pierre-raseev/tiger-timer/Code/FSD/renders/pattern_A_standard_template.png

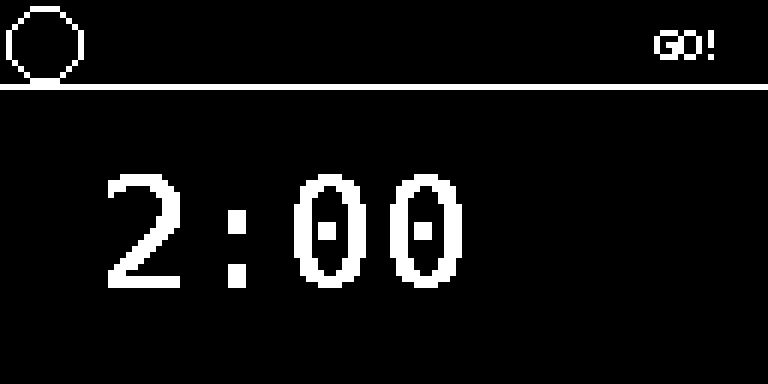
Code/FSD/renders/pattern_A_standard_template.png
