pierre-raseev/tiger-timer/Code/FSD/renders/pattern_B_menu_list.png

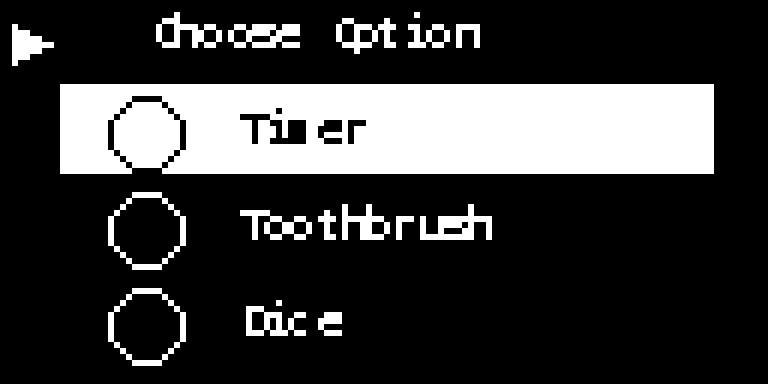
Code/FSD/renders/pattern_B_menu_list.png
