pierre-raseev/tiger-timer/Code/FSD/renders/pattern_C_leave_confirm.png

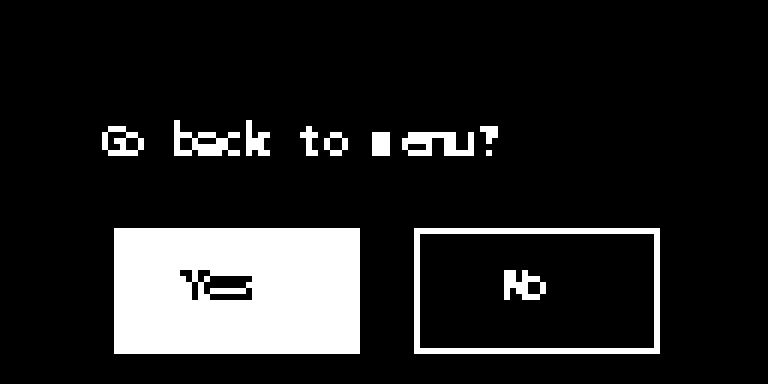
Code/FSD/renders/pattern_C_leave_confirm.png
