pierre-raseev/tiger-timer/Code/FSD/renders/pattern_D_pass_the_bomb.png

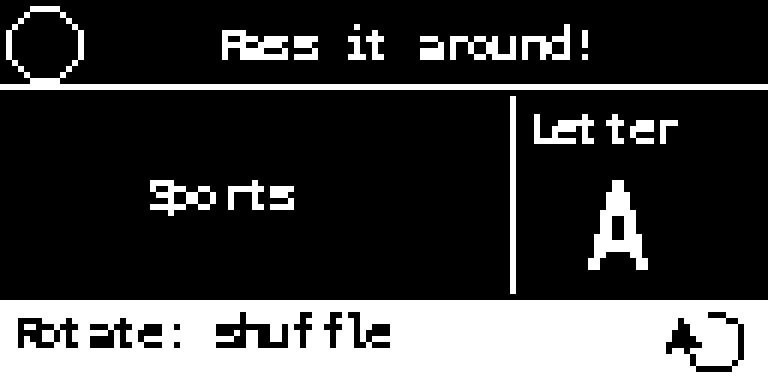
Code/FSD/renders/pattern_D_pass_the_bomb.png
