pierre-raseev/tiger-timer/Code/FSD/renders/pattern_E_remote_config.png

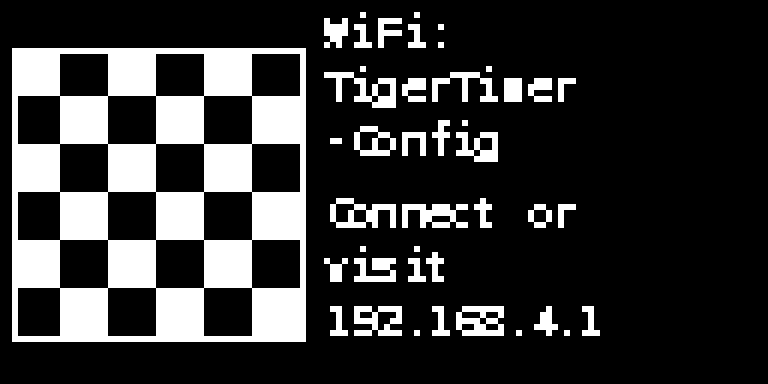
Code/FSD/renders/pattern_E_remote_config.png
