pierre-raseev/tiger-timer/Code/FSD/renders/pattern_F_tetris_ghost.png

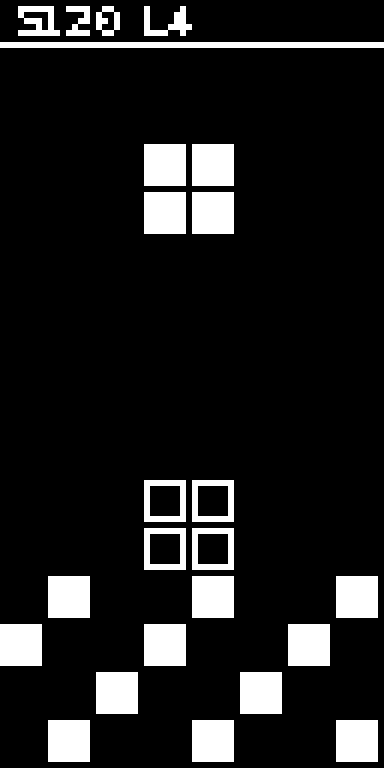
Code/FSD/renders/pattern_F_tetris_ghost.png
