pierre-raseev/tiger-timer/3D/Game Timer v1.9.1.step

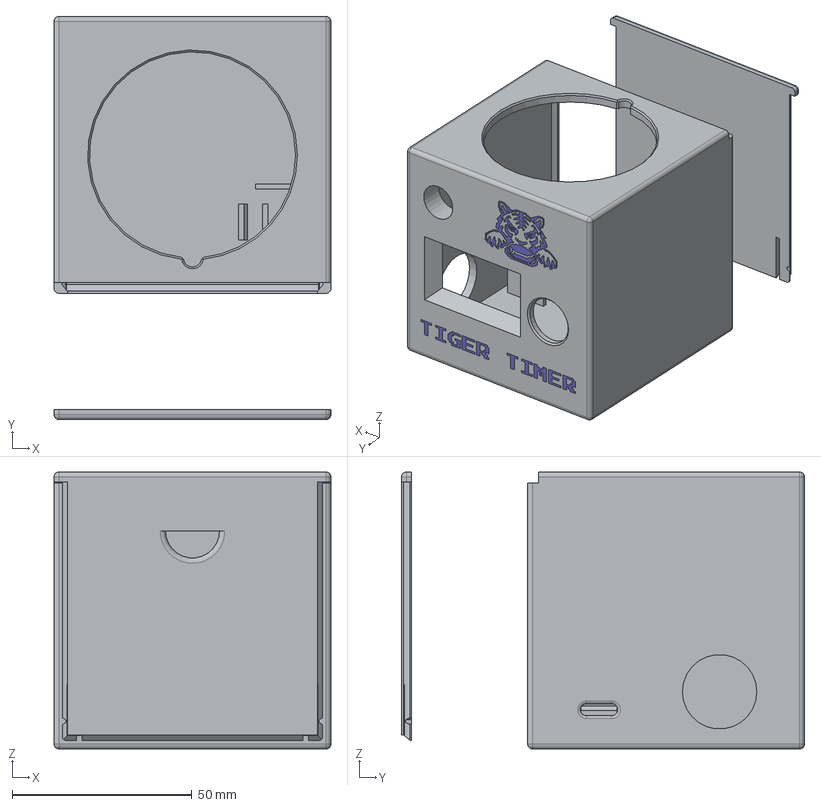
[picture p13: CAD file, 2026-11-11]
3D/Game Timer v1.9.1.step
77.0 x 112.1 x 77.0 mm
Box Body
Back Plate Body
Prints
