pierre-raseev/tiger-timer/3D/Game Timer v1.9.1-double.3mf

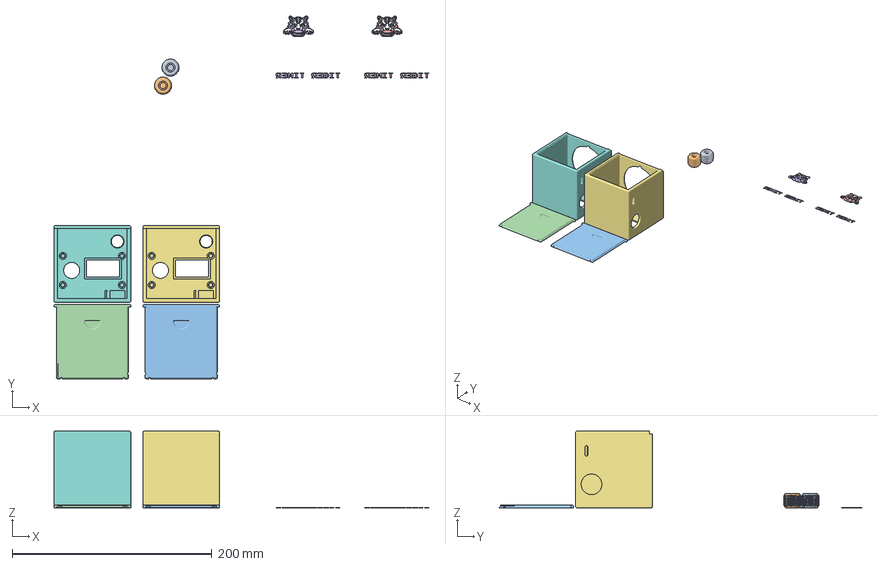
[picture p14: CAD file, 2026-11-11]
3D/Game Timer v1.9.1-double.3mf
375.7 x 363.3 x 77.0 mm
旋钮.STL x 2
Back Plate Body x 2
Prints x 2
Box Body x 2
