pierre-raseev/tiger-timer/(list of files, cad)

Other CAD files:
3D/Game Timer v1.9.1.FCStd
