pierre-raseev/tiger-timer/Code/tiger_timer/tiger_timer.ino

/*
  ============================================================================
  TIGER TIMER  --  firmware for a battery-powered, pocket party-game console
  ============================================================================
  Hardware: Seeed XIAO ESP32C6. Full hardware spec, wiring, and every
  feature's exact intended behavior are documented in the companion
  functional specification document, TigerTimer_FSD.md - if this header and
  that document ever disagree, the FSD is the source of truth; please update
  one or the other rather than letting them drift.

  This comment is intentionally a *summary*, not a duplicate of the FSD - see
  TigerTimer_FSD.md for exact numbers, timings, and per-game rules; see
  TigerTimer_DevPlan.md for how this was originally broken into build phases.

  --- Quick wiring reference (see FSD Sec.2 for the authoritative version) ---
    Arcade button switch   -> D1 + GND   (INPUT_PULLUP, LOW = pressed)
    Arcade button LED (5V) -> D2 + GND   (direct GPIO drive, no boost needed)
    Buzzer (passive piezo) -> D3 + GND   (PWM-driven via LEDC, see playNote())
    OLED + EC11 encoder: one combined module (1.3" SH1106 128x64, I2C addr 0x3C),
      header, seen from the back left to right: 3V3-5V GND BAK TRB TRA PUSH SCL SDA CONFIRM
      SDA->D4  SCL->D5  TRA(CLK)->D10  TRB(DT)->D8  PUSH(SW)->D9  VCC->3V3  GND->GND
      (BAK/CON buttons not connected)
    Power: 3.7V LiPo on the XIAO's BAT pads, through a physical power switch.
    Charged by the XIAO's on-board charger via its USB-C (only while switched on).

  Libraries needed (Arduino Library Manager):
    - "Adafruit SH110X" (pulls in Adafruit GFX Library + Adafruit BusIO)
    - "ArduinoJson" v7.x specifically (used only by web_config.ino)
  Plus two files vendored directly into this sketch (not Library-Manager
  installs - see the comment at the top of each for why):
    - tigertimer_qrcode.h/.c  - a renamed copy of the "QRCode" library, to avoid
      a real collision with a same-named header the ESP32 core bundles
    - press_start_2p_font.h - a custom Adafruit_GFX bitmap font, converted
      from a user-provided TTF, used for the splash/title-bar text

  --- The one input model, used everywhere (FSD Sec.3.2 has the full table) ---
  There are exactly two physical controls and their meaning is consistent
  across every screen except where a specific game overrides it:
    - Arcade button, short press  = confirm / that screen's primary action.
    - Encoder, short click        = same as above in menu-type screens; a
                                     few games (Timer, Chess) repurpose it as
                                     pause/resume instead, since there's
                                     nothing to "confirm" mid-round.
    - Encoder, held + turned      = adjust buzzer volume, from anywhere, any
                                     time - shows a full-screen live indicator
                                     while held, restores the prior screen on
                                     release.
    - Encoder, held 1s (no turn)  = open "Go back to menu?" if inside a game;
                                     does nothing if already in the menu
                                     hierarchy. This is the ONLY way to leave
                                     a game - there is deliberately no
                                     un-confirmed direct exit, so a mid-round
                                     game can never be lost by accident.
  A hold that gets "claimed" by rotation (volume) never also fires a click or
  the long-press menu gesture afterward - see readEncoderButton()/readEncoder()
  and the comment on swClaimedByVolume/swLongFired for exactly how that's
  arbitrated.

  --- What's in this file vs. the other tabs ---
    tiger_timer.ino     - everything except the web config tool: drivers,
                           menu/settings, every game, localization, splash
                           screens, the volume system.
    web_config.ino       - "Config Mode": turns the device into its own WiFi
                           AP serving a small web app (web/config.html) for
                           editing things a single knob can't reasonably
                           edit - menu order/enable, trivia question content,
                           Pass-the-Bomb category list, startup behavior.
                           Entered only from Settings, off otherwise, so it
                           costs zero battery during normal play.
    tigertimer_qrcode (.h/.c), press_start_2p_font.h - vendored assets, see above.
    data/*.csv           - trivia question content (15-column format, see
                           the comment above loadTriviaQuestion() and FSD
                           Sec.5.8).
    config_html.h         - the Config Mode web page, gzipped into the firmware. GENERATED from
                            web/config.html by tools/embed_config_html.py - edit the .html,
                            re-run the script. Lives in firmware (not LittleFS) so a firmware
                            update also updates the page and never touches the trivia files.

  --- Notable design decisions worth knowing before changing things ---
    - MENU_ORDER is a runtime array (not compile-time const) specifically so
      Config Mode can rewrite and persist it; see rebuildVisibleMenu() for
      how disabled games get filtered out of it without losing their saved
      position.
    - Games list their labels by looking up the game's *id*, not by array
      position (see menuLabelForGame()) - this was a real bug fixed early
      on: a positional label array silently mismatches once the menu order
      becomes user-configurable.
    - Word-wrapping is always done by this code's own logic with the display
      library's built-in auto-wrap explicitly disabled first - measuring
      text width with auto-wrap still enabled returns a size that already
      reflects the (possibly mid-word-broken) wrapped layout, not the true
      single-line width, which silently breaks wrap decisions. See
      drawRotatedWrappedText()/drawWrappedText() for the fix.
    - Tetris and Star Drop temporarily call display.setRotation(1) to use
      the panel's long axis as their vertical "falling" axis, and always
      restore rotation(0) before returning - every draw function that does
      this says so explicitly in its own comment; if you add a new rotated
      screen, follow the same bracket-tightly-and-always-restore pattern.
    - Config Mode's WiFi network is deliberately open (no password) so
      phones can captive-portal straight in without typing anything.
    - The trivia CSV format has no quote/escape support (plain comma-split)
      - question/answer text must not contain literal commas or newlines;
      the web editor strips them defensively on save.
  ============================================================================
*/


#include <Wire.h>
#include <Adafruit_GFX.h>
#include "press_start_2p_font.h" // generated from the user-provided PressStart2P-Regular.ttf - same font as the boot splash's TIGER/TIMER wordmark
#include <Adafruit_SH110X.h>
#include <Preferences.h>
#include <LittleFS.h>
#include "esp_sleep.h"
#include "driver/rtc_io.h" // LP-IO pull-up for the deep-sleep wake pin
#include "driver/gpio.h"   // gpio_get_level() - IRAM-safe pin read for the encoder interrupt
#include <WiFi.h>
#include <WebServer.h>
#include <DNSServer.h> // used by web_config.ino for the captive-portal redirect
#include <Update.h>    // firmware update uploaded from the Remote Config page (web_config.ino)
#include "config_html.h" // the Remote Config page, gzipped - GENERATED from web/config.html by tools/embed_config_html.py
#include <ArduinoJson.h>
#include "tigertimer_qrcode.h" // vendored QR encoder (see tigertimer_qrcode.h/.c) - avoids a name collision
                             // with the ESP32 core's own bundled qrcode.h (used for WiFi provisioning)
#include "cp437_utf8.h" // CP437 <-> UTF-8 conversion for the Remote Config web page (web_config.ino)
#include <math.h> // roundf(), used when drawing the WiFi QR code at an arbitrary pixel size // Library Manager: "ArduinoJson" by Benoit Blanchon - used only by the
                          // Config Mode web server (web_config.ino) to parse/build the config page's requests

// ---- Firmware version ----
// Shown on the Remote Config page. Bump it for every change, and publish a GitHub release
// "vX.Y.Z" with the built app .bin attached, so a box can be updated from Remote Config.
const char* FW_VERSION = "1.0.6";
// A firmware upload is only installed if this exact text appears somewhere in the uploaded file,
// i.e. the file really is a Tiger Timer build (any build contains it, since the update code
// below searches for it). Never change it, or older boxes would refuse the new firmware.
const char TT_FW_MARKER[] = "TigerTimer-firmware-id-7d1e9a";

// ---- Pins ----
const int BUTTON_PIN   = D1;
const int BUTTON_LED   = D2;
const int BUZZER_PIN    = D3;
const int ENCODER_CLK  = D10;
const int ENCODER_DT   = D8;
const int ENCODER_SW   = D9;

// ---- OLED ----
#define SCREEN_WIDTH 128
#define SCREEN_HEIGHT 64
#define OLED_I2C_ADDR 0x3C
Adafruit_SH1106G display = Adafruit_SH1106G(SCREEN_WIDTH, SCREEN_HEIGHT, &Wire, -1);

// ---- Splash screen: tiger logo bitmaps (80x53), closed-mouth and open-mouth "roar" frames ----
const int SPLASH_TIGER_WIDTH = 80;
const int SPLASH_TIGER_HEIGHT = 53;
// 80x53 pixels, 530 bytes each
const unsigned char PROGMEM TIGER_BITMAP[] = {
  0x00, 0x00, 0xFC, 0x00, 0x00, 0x00, 0x00, 0x1F, 0x00, 0x00, 0x00, 0x01,
  0x8E, 0x00, 0x00, 0x00, 0x00, 0x71, 0x80, 0x00, 0x00, 0x01, 0x03, 0x80,
  0x3F, 0xFC, 0x01, 0xE0, 0x80, 0x00, 0x00, 0x01, 0x01, 0xE0, 0x3F, 0xFC,
  0x07, 0xC0, 0xC0, 0x00, 0x00, 0x01, 0x39, 0xF1, 0xC3, 0xC3, 0x8F, 0x9C,
  0xC0, 0x00, 0x00, 0x01, 0x3C, 0xFF, 0x03, 0xC0, 0x7F, 0x1C, 0x80, 0x00,
  0x00, 0x01, 0x3C, 0x3C, 0x7F, 0xFE, 0x1E, 0x3C, 0xC0, 0x00, 0x00, 0x01,
  0x9F, 0x31, 0xFF, 0xFF, 0x8C, 0x7D, 0x80, 0x00, 0x00, 0x00, 0x9F, 0xE2,
  0x03, 0xC0, 0x47, 0xF9, 0x00, 0x00, 0x00, 0x00, 0xCF, 0x80, 0x0F, 0xF0,
  0x00, 0xF3, 0x00, 0x00, 0x00, 0x00, 0x6E, 0x00, 0x1F, 0xFC, 0x00, 0x76,
  0x00, 0x00, 0x00, 0x00, 0x3C, 0x30, 0x79, 0xCE, 0x04, 0x3C, 0x00, 0x00,
  0x00, 0x00, 0x38, 0x78, 0xC3, 0xC3, 0x1E, 0x1C, 0x00, 0x00, 0x00, 0x00,
  0x70, 0xC0, 0x07, 0xE0, 0x01, 0x0E, 0x00, 0x00, 0x00, 0x00, 0x61, 0x80,
  0x1F, 0xF8, 0x01, 0x86, 0x00, 0x00, 0x00, 0x00, 0xC3, 0xC0, 0x39, 0xDC,
  0x03, 0xC3, 0x00, 0x00, 0x00, 0x01, 0xD3, 0xC0, 0x21, 0xC4, 0x03, 0xCB,
  0x80, 0x00, 0x00, 0x03, 0xE7, 0xF0, 0x03, 0xC0, 0x07, 0xE7, 0xC0, 0x00,
  0x00, 0x07, 0xE4, 0x78, 0x07, 0xE0, 0x1F, 0x27, 0xE0, 0x00, 0x00, 0x07,
  0xC0, 0x7E, 0x04, 0x30, 0x3F, 0x03, 0xE0, 0x00, 0x00, 0x01, 0xC0, 0x6F,
  0x00, 0x00, 0xF7, 0x03, 0x80, 0x00, 0x00, 0x03, 0x80, 0x6D, 0xC0, 0x03,
  0xB6, 0x01, 0xC0, 0x00, 0x00, 0x03, 0x83, 0x37, 0x70, 0x0E, 0xEE, 0x40,
  0xC0, 0x00, 0x00, 0x07, 0x02, 0x38, 0xF0, 0x0F, 0x1C, 0x40, 0xE0, 0x00,
  0x00, 0x07, 0x33, 0x0F, 0xF0, 0x0F, 0xF0, 0xC4, 0xE0, 0x00, 0x00, 0x0F,
  0x73, 0x87, 0x30, 0x04, 0xE1, 0xC6, 0xF0, 0x00, 0x00, 0x0F, 0xE3, 0x80,
  0x60, 0x06, 0x01, 0xC3, 0xF8, 0x00, 0x00, 0x0B, 0xE3, 0xE0, 0x40, 0x02,
  0x07, 0xC3, 0xD8, 0x00, 0x00, 0x03, 0xE1, 0xFE, 0x00, 0x00, 0x3F, 0x83,
  0xC0, 0x00, 0x00, 0x03, 0xE0, 0xFC, 0x00, 0x00, 0x3F, 0x03, 0xE0, 0x00,
  0x00, 0x0F, 0xF8, 0x38, 0x00, 0x00, 0x1E, 0x1F, 0xF0, 0x00, 0x00, 0x7C,
  0x7E, 0x38, 0x38, 0x1C, 0x0C, 0x3E, 0x3F, 0x00, 0x01, 0x80, 0x3E, 0x70,
  0x1F, 0xF8, 0x0F, 0x7C, 0x01, 0xC0, 0x03, 0x00, 0x0F, 0xF8, 0x0F, 0xF0,
  0x0F, 0xF0, 0x00, 0x60, 0x0C, 0x00, 0x07, 0xFC, 0x07, 0xE0, 0x1F, 0xE0,
  0x00, 0x30, 0x18, 0x00, 0x03, 0xFE, 0x00, 0x00, 0x7F, 0xC0, 0x00, 0x18,
  0x30, 0x00, 0x01, 0xFE, 0x00, 0x00, 0x7F, 0x80, 0x00, 0x0C, 0x60, 0x00,
  0x00, 0xF0, 0x7F, 0xFE, 0x0F, 0x80, 0x00, 0x06, 0xC0, 0x63, 0x08, 0xE3,
  0xFF, 0xFF, 0xC7, 0x98, 0xC6, 0x03, 0xCC, 0x61, 0x8C, 0xCF, 0xFF, 0xFF,
  0xF3, 0xB1, 0xC6, 0x31, 0xCC, 0x61, 0xCF, 0x8F, 0xFF, 0xFF, 0xF1, 0xB3,
  0xC7, 0x3B, 0xDC, 0x73, 0xCF, 0x0F, 0xFF, 0xFF, 0xF0, 0xF3, 0xCE, 0x39,
  0xDC, 0xF1, 0xDE, 0x63, 0xFF, 0xFF, 0xC6, 0x7B, 0xCF, 0x39, 0xDD, 0xE3,
  0xD8, 0xF0, 0xFF, 0xFF, 0x0F, 0x19, 0xC7, 0xBB, 0x7D, 0xE3, 0xF1, 0xB0,
  0x00, 0x00, 0x1F, 0x8F, 0xC7, 0xBE, 0x1D, 0xB2, 0x63, 0xB0, 0x00, 0x00,
  0xFD, 0xC6, 0x4D, 0xBC, 0x07, 0x9E, 0x03, 0xB0, 0xC0, 0x03, 0xFD, 0xC0,
  0x79, 0xE0, 0x03, 0x8E, 0x03, 0x9C, 0xFF, 0xFF, 0xF9, 0xC0, 0x71, 0xC0,
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
};

// ---- Splash screen: "TIGER"/"TIMER" wordmark bitmaps (40x8 each), rendered in the Press Start 2P
// pixel font, used for the slide-in animation ----
const int SPLASH_WORD_WIDTH = 40;
const int SPLASH_WORD_HEIGHT = 8;
// 40x8 pixels each, 40 bytes each
const unsigned char PROGMEM WORD_TIGER_BITMAP[] = {
  0x7E, 0x7E, 0x3E, 0xFE, 0xFC, 0x18, 0x18, 0x60, 0xC0, 0xC6, 0x18, 0x18,
  0xC0, 0xC0, 0xC6, 0x18, 0x18, 0xCE, 0xFC, 0xCE, 0x18, 0x18, 0xC6, 0xC0,
  0xF8, 0x18, 0x18, 0x66, 0xC0, 0xDC, 0x18, 0x7E, 0x3E, 0xFE, 0xCE, 0x00,
  0x00, 0x00, 0x00, 0x00,
};

const unsigned char PROGMEM WORD_TIMER_BITMAP[] = {
  0x7E, 0x7E, 0xC6, 0xFE, 0xFC, 0x18, 0x18, 0xEE, 0xC0, 0xC6, 0x18, 0x18,
  0xFE, 0xC0, 0xC6, 0x18, 0x18, 0xD6, 0xFC, 0xCE, 0x18, 0x18, 0xD6, 0xC0,
  0xF8, 0x18, 0x18, 0xC6, 0xC0, 0xDC, 0x18, 0x7E, 0xC6, 0xFE, 0xCE, 0x00,
  0x00, 0x00, 0x00, 0x00,
};



// ---- Game modes ----
const int GAME_TIMER      = 0;
const int GAME_REFLEX     = 1;
const int GAME_DICE       = 2;
const int GAME_CHESS      = 3;
const int GAME_HOTPOTATO  = 4; // "Pass the Bomb" - internal name kept from its original Hot Potato build
const int GAME_STOPWATCH  = 5;  // ids 5+ shifted down by one when Turn Order was removed - saved
const int GAME_TRIVIA     = 6;  // settings from older firmware are converted once at boot
const int GAME_TOOTHBRUSH = 7;  // (migrateSavedGameIds in web_config.ino)
const int GAME_TETRIS     = 8;
const int GAME_STARDROP   = 9;
const int GAME_SNAKE      = 10;
const int GAME_SIMPLEMORSE = 11;
const int GAME_PONG       = 12; // added after the Turn Order removal - see migrateSavedGameIds (idVer 3)
const int GAME_COUNT      = 13;
int currentGame = GAME_TIMER;

const int MENU_SETTINGS = 100; // sentinel: a menu entry that isn't a playable game
const int MENU_INSTRUCTIONS = 101; // sentinel: another non-game entry, the global instructions screen
const int MENU_COUNT = 15;
// Default/fallback order, used on first boot and whenever a saved order in flash is missing or invalid.
const int DEFAULT_MENU_ORDER[MENU_COUNT] = {GAME_TIMER, GAME_TOOTHBRUSH, GAME_DICE, GAME_REFLEX, GAME_CHESS, GAME_HOTPOTATO, GAME_STOPWATCH, GAME_TRIVIA, GAME_TETRIS, GAME_STARDROP, GAME_SNAKE, GAME_PONG, GAME_SIMPLEMORSE, MENU_INSTRUCTIONS, MENU_SETTINGS};
// Actual display order - no longer const: Config Mode (web_config.ino) can rewrite this at runtime
// and persist it to flash. Everything that reads MENU_ORDER elsewhere in the sketch is unaffected,
// since it's still just an array of GAME_* ids in display order.
int MENU_ORDER[MENU_COUNT];

// Filtered view of MENU_ORDER with disabled games left out (Settings is never filtered out) - this,
// not MENU_ORDER directly, is what the menu screen actually navigates/draws. Rebuilt by
// rebuildVisibleMenu() (web_config.ino) whenever MENU_ORDER or a game's enabled state changes.
int visibleMenuOrder[MENU_COUNT];
int visibleMenuCount = MENU_COUNT;

// Per-game enable/disable, indexed by GAME_* id. A disabled game is skipped in the on-device
// menu (see visibleMenuOrder above) but keeps its saved position in MENU_ORDER, so re-enabling
// it later puts it back where it was. Settings can't be disabled and isn't represented here.
bool gameEnabled[GAME_COUNT];

int menuPositionForGame(int gameId) {
  for (int i = 0; i < visibleMenuCount; i++) {
    if (visibleMenuOrder[i] == gameId) return i;
  }
  return 0;
}

bool inMenu = false;
int menuSelection = GAME_TIMER;

// ---- "Go back to menu?" confirmation - shown before actually leaving a game, so an accidental
// long-press can't lose game progress ----
bool inLeaveConfirm = false;
int leaveConfirmSelection = 0; // 0 = Yes (default), 1 = No

// ---- Instructions screen (top of the main menu) ----
bool inInstructions = false;

// ---- Settings submenu ----
const int SETTINGS_LANGUAGE    = 0;
const int SETTINGS_TIMER_STEP  = 1;
const int SETTINGS_CONFIG_MODE = 2; // opens Remote Config: starts the WiFi AP + web config server
const int SETTINGS_COUNT = 3;
bool inSettingsMenu = false;
int settingsSelection = SETTINGS_LANGUAGE;

// ---- Language / translations ----
const int LANG_EN = 0;
const int LANG_FR = 1;
const int LANG_ES = 2;
const int LANG_COUNT = 3;
int currentLanguage = LANG_EN; // overwritten from flash in setup()
bool inLanguageSelect = false;

// ---- Timer step selection ----
const long TIMER_STEP_AUTO = 0; // sentinel: 0 means "use the same ramped step as the Chess clock"
const long TIMER_STEP_OPTIONS[] = {TIMER_STEP_AUTO, 1, 5, 10, 30, 60};
const int TIMER_STEP_OPTION_COUNT = 6;
const int TIMER_STEP_DEFAULT_INDEX = 0; // Auto
int currentTimerStepIndex = TIMER_STEP_DEFAULT_INDEX; // overwritten from flash in setup()
bool inTimerStepSelect = false;

Preferences prefs;

const char* LANGUAGE_NAMES[LANG_COUNT] = {"English", "Fran\x87" "ais", "Espa\xA4ol"}; // native names, never translated

const int STR_SELECT_GAME = 0;
const int STR_MENU_TIMER = 1;
const int STR_MENU_DICE = 2;
const int STR_MENU_REFLEX = 3;
const int STR_MENU_LANGUAGE = 4;
const int STR_SET_TIME = 5;
const int STR_READY = 6;
const int STR_GO_STATUS = 7;
const int STR_GO_BIG = 8;
const int STR_TOO_SOON = 9;
const int STR_WAIT_BIG = 10;
const int STR_DONT_HIT_YET = 11;
const int STR_PRESS_TO_START = 12;
const int STR_BEST = 13;
const int STR_CHOOSE_DICE_TYPE = 14;
const int STR_PRESS_TO_ROLL = 15;
const int STR_TOTAL = 16;
const int STR_ROLLING = 17;
const int STR_CHOOSE_LANGUAGE = 18;
const int STR_MENU_SETTINGS = 19;
const int STR_SETTINGS_TITLE = 20;
const int STR_MENU_TIMER_STEP = 21;
const int STR_CHOOSE_TIMER_STEP = 22;
const int STR_MENU_CHESS = 23;
const int STR_CHOOSE_START_TIME = 24;
const int STR_CHOOSE_INCREMENT = 25;
const int STR_PAUSED = 26;
const int STR_OUT_OF_TIME = 27;
const int STR_PUSH = 28;
const int STR_AUTO = 29;
const int STR_PLAYER = 30;
const int STR_WHITE_STARTING = 31;
const int STR_WHITE_TURN = 32;
const int STR_BLACK_TURN = 33;
const int STR_WHITE = 34;
const int STR_BLACK = 35;
const int STR_MENU_HOTPOTATO = 36;
const int STR_HP_ARM = 37;
const int STR_HP_ARMED = 38;
const int STR_HP_BOOM = 39;
const int STR_SPINNING = 40;
const int STR_MENU_STOPWATCH = 41;
const int STR_LAP = 42;
const int STR_MENU_TRIVIA = 43;
const int STR_CHOOSE_CATEGORY = 44;
const int STR_CHOOSE_LEVEL = 45;
const int STR_CAT_FOOTBALL = 46;
const int STR_CAT_GEOGRAPHY = 47;
const int STR_CAT_SCIENCE = 48;
const int STR_CAT_HISTORY = 49;
const int STR_LEVEL_JUNIOR = 50;
const int STR_LEVEL_CURIOUS = 51;
const int STR_LEVEL_MASTER = 52;
const int STR_CAT_RANDOM = 53;
const int STR_CAT_GENERAL = 54;
const int STR_CAT_MYTHOLOGY = 55;
const int STR_CAT_ART = 56;
const int STR_CAT_ANIMALS = 57;
const int STR_QUESTION_LABEL = 58;
const int STR_ANSWERS_LABEL = 59;
const int STR_TURN_ANSWERS = 60;
const int STR_TURN_QUESTION = 61;
const int STR_CLICK_NEXT = 62;
const int STR_MENU_TOOTHBRUSH = 63;
const int STR_CHOOSE_BRUSH_TIME = 64;
const int STR_ZONE_UPPER = 65; // toothbrush zone label, line 1
const int STR_ZONE_LOWER = 66;
const int STR_ZONE_LEFT = 67;  // toothbrush zone label, line 2
const int STR_ZONE_RIGHT = 68;
const int STR_BRUSHING_DONE = 69;
const int STR_MENU_CONFIG_MODE = 70;
const int STR_CONFIG_STARTING = 71;
const int STR_CONFIG_WIFI_LABEL = 72;
const int STR_CONFIG_CONNECT_OR = 73;
const int STR_CONFIG_VISIT = 74;
const int STR_CONFIG_PRESS_EXIT = 75; // no longer shown on the Config Mode screen itself (no room next to the QR code), kept for potential reuse
const int STR_MENU_INSTRUCTIONS = 76;
const int STR_LEAVE_CONFIRM_TITLE = 77;
const int STR_YES = 78;
const int STR_NO = 79;
const int STR_INSTR_MENU = 80;
const int STR_INSTR_VOLUME = 81;
const int STR_INSTR_SETTINGS = 82;
const int STR_TRIVIA_PREV = 83;
const int STR_TRIVIA_ANS = 84;
const int STR_TRIVIA_QUES = 85;
const int STR_TRIVIA_NEXT = 86;
const int STR_MENU_TETRIS = 87;
const int STR_TETRIS_PRESS_START = 88;
const int STR_TETRIS_GAME_OVER = 89;
const int STR_TETRIS_SCORE = 90;
const int STR_MENU_STARDROP = 91;
const int STR_STARDROP_PRESS_START = 92;
const int STR_STARDROP_GAME_OVER = 93;
const int STR_STARDROP_SCORE = 94;
const int STR_STARDROP_HIGH = 95;
const int STR_HP_STARTING_WITH = 96; // "starting with" (joins category + letter, e.g. "Country starting with A")
const int STR_HP_CAT_COUNTRIES = 97;
const int STR_HP_CAT_CITIES = 98;
const int STR_HP_CAT_FOOD = 99;
const int STR_HP_CAT_CELEBRITIES = 100;
const int STR_HP_CAT_CARTOON = 101;
const int STR_HP_CAT_HOME = 102;
const int STR_HP_CAT_SCHOOL = 103;
const int STR_HP_CAT_WEAR = 104;
const int STR_HP_CAT_SPORTS = 105;
const int STR_HP_CAT_BODYPARTS = 106;
const int STR_HP_CAT_INSTRUMENTS = 107;
const int STR_HP_CAT_RED = 108;
const int STR_HP_CAT_BLUE = 109;
const int STR_HP_CAT_GREEN = 110;
const int STR_HP_CAT_COLD = 111;
const int STR_HP_CAT_WARM = 112;
const int STR_HP_CAT_FLY = 113;
const int STR_HP_CAT_COLOURS = 114;
const int STR_HP_CAT_NOISE = 115;
const int STR_HP_CAT_BREAK = 116;
const int STR_HP_LETTER_LABEL = 117;
const int STR_HP_ROTATE_HINT = 118;
const int STR_BRUSH_ACTIVE = 119;
const int STR_MENU_SNAKE = 120;
const int STR_MENU_SIMPLEMORSE = 121;
const int STR_SIMON_SENTENCE_LABEL = 122;
const int STR_SIMON_WATCH = 123;
const int STR_SIMON_YOUR_TURN = 124;
const int STR_SIMON_COMPLETE = 125;
const int STR_SIMON_ROUND = 126;
const int STR_ZONE_FRONT = 127; // toothbrush zone label, line 2
const int STR_MENU_PONG = 128;
const int STR_UPDATE_CONFIRM = 129;  // firmware update from Remote Config (web_config.ino)
const int STR_UPDATE_BTN_YES = 130;
const int STR_UPDATE_KNOB_NO = 131;
const int STR_UPDATE_RUNNING = 132;
const int STR_UPDATE_RESTART = 133;
const int STR_UPDATE_FAILED = 134;
const int STR_UPDATE_WAITING = 135;
const int STR_INSTR_SETTINGS2 = 136; // second line of STR_INSTR_SETTINGS (doesn't fit on one line)
const int NUM_STRINGS = 137;

const char* TRANSLATIONS[NUM_STRINGS][LANG_COUNT] = {
  /* STR_SELECT_GAME          */{"Choose Option", "Choisir option", "Elegir opcion"},
  /* STR_MENU_TIMER           */{"Timer", "Minuteur", "Temporizador"},
  /* STR_MENU_DICE            */{"Dice", "D\x82s", "Dados"},
  /* STR_MENU_REFLEX          */{"Reflex", "R\x82" "flexe", "Reflejos"},
  /* STR_MENU_LANGUAGE        */{"Language", "Langue", "Idioma"},
  /* STR_SET_TIME             */{"Set time", "R\x82gler temps", "Ajustar tiempo"},
  /* STR_READY                */{"Ready", "Pr\x88t", "Listo"},
  /* STR_GO_STATUS            */{"GO!", "GO !", "YA!"},
  /* STR_GO_BIG               */{"GO", "GO", "YA"},
  /* STR_TOO_SOON             */{"TOO SOON", "TROP TOT", "MUY PRONTO"},
  /* STR_WAIT_BIG             */{"WAIT", "ATTENDS", "ESPERA"},
  /* STR_DONT_HIT_YET         */{"Don't hit yet!", "N'appuie pas !", "No pulses aun!"},
  /* STR_PRESS_TO_START       */{"Press to start", "Appuyez pour jouer", "Pulsa para empezar"},
  /* STR_BEST                 */{"Best", "Meilleur", "Mejor"},
  /* STR_CHOOSE_DICE_TYPE     */{"Choose Dice Type", "Type de d\x82", "Tipo de dado"},
  /* STR_PRESS_TO_ROLL        */{"Press to roll", "Appuyez lancer", "Pulsa para tirar"},
  /* STR_TOTAL                */{"Total", "Total", "Total"},
  /* STR_ROLLING              */{"Rolling...", "Lancer...", "Tirando..."},
  /* STR_CHOOSE_LANGUAGE      */{"Choose Language", "Choisir langue", "Elegir idioma"},
  /* STR_MENU_SETTINGS        */{"Settings", "Param\x8Atres", "Ajustes"},
  /* STR_SETTINGS_TITLE       */{"Settings", "Param\x8Atres", "Ajustes"},
  /* STR_MENU_TIMER_STEP      */{"Timer Step", "Intervalle", "Intervalo"},
  /* STR_CHOOSE_TIMER_STEP    */{"Choose Timer Step", "Choisir intervalle", "Elegir intervalo"},
  /* STR_MENU_CHESS           */{"Chess Clock", "Horloge \x82" "checs", "Reloj ajedrez"},
  /* STR_CHOOSE_START_TIME    */{"Choose Start Time", "Choisir temps", "Elegir tiempo"},
  /* STR_CHOOSE_INCREMENT     */{"Choose Increment", "Choisir incr\x82ment", "Elegir incremento"},
  /* STR_PAUSED               */{"Paused", "Pause", "Pausado"},
  /* STR_OUT_OF_TIME          */{"out of time", "temps \x82" "coul\x82", "sin tiempo"},
  /* STR_PUSH                 */{"Push", "Pousse", "Pulsa"},
  /* STR_AUTO                 */{"Auto", "Auto", "Auto"},
  /* STR_PLAYER               */{"Player", "Joueur", "Jugador"},
  /* STR_WHITE_STARTING       */{"White is starting", "Blancs commencent", "Empiezan blancas"},
  /* STR_WHITE_TURN           */{"White Turn", "Tour blancs", "Turno blancas"},
  /* STR_BLACK_TURN           */{"Black Turn", "Tour noirs", "Turno negras"},
  /* STR_WHITE                */{"White", "Blancs", "Blancas"},
  /* STR_BLACK                */{"Black", "Noirs", "Negras"},
  /* STR_MENU_HOTPOTATO       */{"Pass the Bomb", "Passe la bombe", "Pasa la bomba"},
  /* STR_HP_ARM               */{"Press to arm", "Appuyez pour armer", "Pulsa para armar"},
  /* STR_HP_ARMED             */{"Pass it around!", "Faites tourner !", "Pasala rapido!"},
  /* STR_HP_BOOM              */{"BOOM!", "BOOM !", "BOOM!"},
  /* STR_SPINNING             */{"Spinning...", "Tirage...", "Girando..."},
  /* STR_MENU_STOPWATCH       */{"Stopwatch", "Chronom\x8Atre", "Cronometro"},
  /* STR_LAP                  */{"Lap", "Tour", "Vuelta"},
  /* STR_MENU_TRIVIA          */{"Trivia", "Quiz", "Trivia"},
  /* STR_CHOOSE_CATEGORY      */{"Choose Category", "Choisir cat\x82gorie", "Elegir categoria"},
  /* STR_CHOOSE_LEVEL         */{"Choose Level", "Choisir niveau", "Elegir nivel"},
  /* STR_CAT_FOOTBALL         */{"Sports", "Sport", "Deportes"},
  /* STR_CAT_GEOGRAPHY        */{"Geography", "G\x82ographie", "Geografia"},
  /* STR_CAT_SCIENCE          */{"Science", "Sciences", "Ciencias"},
  /* STR_CAT_HISTORY          */{"History", "Histoire", "Historia"},
  /* STR_LEVEL_JUNIOR         */{"Junior", "Junior", "Junior"},
  /* STR_LEVEL_CURIOUS        */{"Curious", "Curieux", "Curioso"},
  /* STR_LEVEL_MASTER         */{"Master", "Maitre", "Maestro"},
  /* STR_CAT_RANDOM           */{"Random", "Al\x82" "atoire", "Aleatorio"},
  /* STR_CAT_GENERAL          */{"General", "General", "General"},
  /* STR_CAT_MYTHOLOGY        */{"Mythology", "Mythologie", "Mitologia"},
  /* STR_CAT_ART              */{"Art", "Art", "Arte"},
  /* STR_CAT_ANIMALS          */{"Animals", "Animaux", "Animales"},
  /* STR_QUESTION_LABEL       */{"Question", "Question", "Pregunta"},
  /* STR_ANSWERS_LABEL        */{"Answers", "Reponses", "Respuestas"},
  /* STR_TURN_ANSWERS         */{"Q/A", "Q/R", "P/R"},
  /* STR_TURN_QUESTION        */{"Turn for Question", "Tourner: Question", "Girar: Pregunta"},
  /* STR_CLICK_NEXT           */{"Next", "Suivant", "Siguiente"},
  /* STR_MENU_TOOTHBRUSH      */{"Toothbrush", "Brossage", "Cepillado"},
  /* STR_CHOOSE_BRUSH_TIME    */{"Choose brush time", "Choisir la duree", "Elegir duracion"},
  /* STR_ZONE_UPPER           */{"Upper", "Haut", "Arriba"},
  /* STR_ZONE_LOWER           */{"Lower", "Bas", "Abajo"},
  /* STR_ZONE_LEFT            */{"left", "gauche", "izqda."},
  /* STR_ZONE_RIGHT           */{"right", "droite", "derecha"},
  /* STR_BRUSHING_DONE        */{"All done!", "Termin\x82 !", "Listo!"},
  /* STR_MENU_CONFIG_MODE     */{"Remote Config", "Config distante", "Config remota"},
  /* STR_CONFIG_STARTING      */{"Starting WiFi...", "Demarrage WiFi...", "Iniciando WiFi..."},
  /* STR_CONFIG_WIFI_LABEL    */{"WiFi:", "WiFi :", "WiFi:"},
  /* STR_CONFIG_CONNECT_OR    */{"Connect or", "Connectez", "Conecta o"},
  /* STR_CONFIG_VISIT         */{"visit", "ou visitez", "visita"},
  /* STR_CONFIG_PRESS_EXIT    */{"Press to exit", "Appuyez pour quitter", "Pulsa para salir"},
  /* STR_MENU_INSTRUCTIONS    */{"Instructions", "Instructions", "Instrucciones"},
  /* STR_LEAVE_CONFIRM_TITLE  */{"Go back to menu?", "Retour au menu ?", "Volver al menu?"},
  /* STR_YES                  */{"Yes", "Oui", "Si"},
  /* STR_NO                   */{"No", "Non", "No"},
  /* STR_INSTR_MENU           */{"Menu: hold knob 1s", "Menu: tenir 1s", "Menu: mant. 1s"},
  /* STR_INSTR_VOLUME         */{"Volume: hold+turn", "Volume: tenir+tourner", "Volumen: mant.+gira"},
  /* STR_INSTR_SETTINGS       */{"More: Go to Settings", "Plus: voir Param\x8Atres", "Mas: ve a Ajustes"},
  /* STR_TRIVIA_PREV          */{"Prev", "Prec.", "Ant."},
  /* STR_TRIVIA_ANS           */{"Ans", "Rep.", "Resp."},
  /* STR_TRIVIA_QUES          */{"Ques", "Quest.", "Preg."},
  /* STR_TRIVIA_NEXT          */{"Next", "Suiv.", "Sig."},
  /* STR_MENU_TETRIS          */{"Tetris", "Tetris", "Tetris"},
  /* STR_TETRIS_PRESS_START   */{"Press to start", "Appuyez pour jouer", "Pulsa para jugar"},
  /* STR_TETRIS_GAME_OVER     */{"Game Over", "Partie terminee", "Fin del juego"},
  /* STR_TETRIS_SCORE         */{"Score", "Score", "Puntos"},
  /* STR_MENU_STARDROP        */{"Star Drop", "Star Drop", "Star Drop"},
  /* STR_STARDROP_PRESS_START */{"Press to start", "Appuyez pour jouer", "Pulsa para jugar"},
  /* STR_STARDROP_GAME_OVER   */{"Game Over", "Partie terminee", "Fin del juego"},
  /* STR_STARDROP_SCORE       */{"Score", "Score", "Puntos"},
  /* STR_STARDROP_HIGH        */{"Best", "Record", "Record"},
  /* STR_HP_STARTING_WITH     */{"starting with", "qui commence par", "que empiece con"},
  /* STR_HP_CAT_COUNTRIES     */{"Country", "Pays", "Pais"},
  /* STR_HP_CAT_CITIES        */{"City", "Ville", "Ciudad"},
  /* STR_HP_CAT_FOOD          */{"Food", "Nourriture", "Comida"},
  /* STR_HP_CAT_CELEBRITIES   */{"Celebrity", "Celebrite", "Famoso"},
  /* STR_HP_CAT_CARTOON       */{"Cartoon character", "Perso. de dessin anime", "Personaje de dibujos"},
  /* STR_HP_CAT_HOME          */{"Thing at home", "Objet de la maison", "Cosa de casa"},
  /* STR_HP_CAT_SCHOOL        */{"Thing at school", "Objet de l'ecole", "Cosa del colegio"},
  /* STR_HP_CAT_WEAR          */{"Thing you wear", "Vetement", "Cosa que te pones"},
  /* STR_HP_CAT_SPORTS        */{"Sport", "Sport", "Deporte"},
  /* STR_HP_CAT_BODYPARTS     */{"Body part", "Partie du corps", "Parte del cuerpo"},
  /* STR_HP_CAT_INSTRUMENTS   */{"Musical instrument", "Instrument de musique", "Instrumento musical"},
  /* STR_HP_CAT_RED           */{"Red thing", "Chose rouge", "Cosa roja"},
  /* STR_HP_CAT_BLUE          */{"Blue thing", "Chose bleue", "Cosa azul"},
  /* STR_HP_CAT_GREEN         */{"Green thing", "Chose verte", "Cosa verde"},
  /* STR_HP_CAT_COLD          */{"Cold thing", "Chose froide", "Cosa fria"},
  /* STR_HP_CAT_WARM          */{"Warm thing", "Chose chaude", "Cosa caliente"},
  /* STR_HP_CAT_FLY           */{"Thing that flies", "Chose qui vole", "Cosa que vuela"},
  /* STR_HP_CAT_COLOURS       */{"Colour", "Couleur", "Color"},
  /* STR_HP_CAT_NOISE         */{"Thing that's noisy", "Chose qui fait du bruit", "Cosa que hace ruido"},
  /* STR_HP_CAT_BREAK         */{"Thing that breaks", "Chose qui se casse", "Cosa que se rompe"},
  /* STR_HP_LETTER_LABEL      */{"Letter", "Lettre", "Letra"},
  /* STR_HP_ROTATE_HINT       */{"Rotate: shuffle", "Tourner: m\x82langer", "Girar: mezclar"},
  /* STR_BRUSH_ACTIVE         */{"Brush!", "Brosse !", "Cepilla!"},
  /* STR_MENU_SNAKE           */{"Snake", "Snake", "Snake"},
  /* STR_MENU_SIMPLEMORSE     */{"SimpleMorse", "SimpleMorse", "SimpleMorse"},
  /* STR_SIMON_SENTENCE_LABEL */{"Word in Morse", "Mot en morse", "Palabra en morse"},
  /* STR_SIMON_WATCH          */{"Watch!", "Regarde !", "Mira!"},
  /* STR_SIMON_YOUR_TURN      */{"Your turn", "A toi", "Tu turno"},
  /* STR_SIMON_COMPLETE       */{"Complete!", "Reussi !", "Completo!"},
  /* STR_SIMON_ROUND          */{"Round", "Manche", "Ronda"},
  /* STR_ZONE_FRONT           */{"front", "devant", "frente"},
  /* STR_MENU_PONG            */{"Pong", "Pong", "Pong"},
  /* STR_UPDATE_CONFIRM       */{"Install update?", "Installer la MAJ ?", "Actualizar?"},
  /* STR_UPDATE_BTN_YES       */{"Button: install", "Bouton : installer", "Boton: instalar"},
  /* STR_UPDATE_KNOB_NO       */{"Knob: cancel", "Molette : annuler", "Rueda: cancelar"},
  /* STR_UPDATE_RUNNING       */{"Updating...", "Mise \x85 jour...", "Actualizando..."},
  /* STR_UPDATE_RESTART       */{"Restarting...", "Red\x82marrage...", "Reiniciando..."},
  /* STR_UPDATE_FAILED        */{"Update failed", "\x90" "chec de la MAJ", "Error de update"},
  /* STR_UPDATE_WAITING       */{"Waiting for file", "Attente du fichier", "Esperando archivo"},
  /* STR_INSTR_SETTINGS2      */{"> Remote Config", "> Config distante", "> Config remota"},

};

const char* T(int stringId) {
  if (stringId < 0 || stringId >= NUM_STRINGS) return "";
  int lang = constrain(currentLanguage, 0, LANG_COUNT - 1);
  return TRANSLATIONS[stringId][lang];
}

// ---- Timer settings ----
const long DEFAULT_TIME = 120; // 2:00
const long MIN_TIME     = 10;  // 0:10
const long MAX_TIME     = 5400; // 90:00

long presetTime    = DEFAULT_TIME; // chosen length, used each time the button starts a run
long remainingTime = DEFAULT_TIME; // seconds left, counts down while running
long runStartTime  = DEFAULT_TIME; // snapshot of remainingTime at the moment the run started (for blink-rate %)
bool running = false;
bool timerPaused = false; // pauses the countdown without resetting it, toggled by the encoder's click

unsigned long lastSecondTick = 0;

// blink state
bool ledBlinkState = false;
unsigned long lastBlinkToggle = 0;

// button debounce
int lastButtonFlicker = HIGH; // raw reading from the previous loop pass
int buttonState       = HIGH; // confirmed/debounced state
unsigned long lastButtonEdgeTime = 0;
const unsigned long BUTTON_DEBOUNCE_MS = 20; // raised back up from 10ms after flaky/double-trigger behavior
unsigned long buttonPressStart = 0;
bool buttonPressConsumed = false; // true once this press already did its job on the way DOWN (e.g. a Reflex
                                  // false start, or waking the screen) - its release then dispatches nothing

// encoder state: decoded in a pin-change interrupt on both CLK and DT (full quadrature), so a fast
// spin isn't missed while loop() is busy with a screen transfer or a sound, and contact bounce
// cancels itself out (+1 then -1) instead of reading as a turn the wrong way. readEncoder() then
// consumes encoderPendingDetents.
volatile int encoderPendingDetents = 0; // + clockwise, - counter-clockwise, not yet acted on
volatile uint8_t encoderLastAB = 3;     // last (CLK<<1)|DT, 3 = both high = detent rest position
volatile int8_t encoderStepAcc = 0;     // quarter-steps since the last rest position
gpio_num_t encoderClkGpio, encoderDtGpio;

// encoder push-button: plain click = context action (confirm / pause / etc); hold+turn = volume;
// hold 1s alone (no turn) = open/close the menu
int lastSwFlicker = HIGH;
int swState        = HIGH;
unsigned long lastSwEdgeTime = 0;
const unsigned long SW_DEBOUNCE_MS = 40;
bool swClaimedByVolume = false; // true once a rotation-while-held adjusts volume, so release doesn't also fire a click
unsigned long swPressStart = 0;
bool swLongFired = false; // true once the 1s hold has already opened/closed the menu, so release doesn't also fire a click
bool swWakeConsumed = false; // true when this hold woke the sleeping screen - it then fires no click or long-press
const unsigned long ENCODER_LONG_PRESS_MS = 1000;

// ---- Reflex game state ----
const int REFLEX_READY   = 0; // waiting for a button press to arm a round
const int REFLEX_WAITING = 1; // armed, light not on yet - pressing now is a false start
const int REFLEX_LIT     = 2; // light is on, waiting for the hit
int reflexState = REFLEX_READY;
unsigned long reflexArmTime = 0;
unsigned long reflexDelay = 0;
unsigned long reflexLightOnTime = 0;
long lastReactionMs = -1;      // -1 = no result yet
long reflexHighScoreMs = -1;   // -1 = no best time yet this session
unsigned long falseStartUntil = 0; // show "Too soon!" until this millis() timestamp
const unsigned long REFLEX_MIN_DELAY_MS = 1500;
const unsigned long REFLEX_MAX_DELAY_MS = 4000;
const unsigned long FALSE_START_DISPLAY_MS = 1500;

// ---- Dice Roll state ----
const int DICE_SIDES[]  = {4, 6, 8, 10, 12, 20};
const int DICE_TYPE_COUNT = 6;
const int MAX_DICE_COUNT = 5;

const int DICE_SELECT_TYPE = 0; // choosing the die type, shown right after entering the game
const int DICE_ROLLING     = 1; // main screen: encoder picks dice count, button rolls
int diceScreenState = DICE_SELECT_TYPE;

int currentDieIndex = 1;  // default d6
int diceCount = 1;        // how many dice to roll, 1-5

int diceResults[MAX_DICE_COUNT]; // results from the most recent roll
int diceResultSides = 6;         // die type used for that roll
int diceResultCount = 0;         // how many dice were rolled (0 = no roll yet since choosing the type)

// ---- Chess Timer state ----
const int CHESS_SETUP_TIME      = 0; // choosing starting minutes per player
const int CHESS_SETUP_INCREMENT = 1; // choosing the increment added back after each move
const int CHESS_PLAYING         = 2; // one player's clock running (or paused)
const int CHESS_GAME_OVER       = 3; // a player's clock hit 0
int chessScreenState = CHESS_SETUP_TIME;

long chessStartSeconds = 300; // 30 (0:30) to 5400 (90:00), stepped via rampedTimeStep() below
const long CHESS_START_MIN_SECONDS = 30;
const long CHESS_START_MAX_SECONDS = 5400; // 90:00
int chessIncrementSeconds = 0; // 0-60, steps of 10

long chessTimeP1 = 0; // seconds remaining, each player
long chessTimeP2 = 0;
int chessActivePlayer = 1; // 1 or 2 - whoever's clock is currently running
bool chessStarted = false; // false = showing P1's time, waiting for the first press to actually start
bool chessPaused = false;
unsigned long chessLastTick = 0;
long chessMaxP1 = 0; // highest time each player has ever had (starting time + increments) - bar reference
long chessMaxP2 = 0;
int chessLoser = 0; // 0 = no result yet, 1 or 2 = who ran out of time
unsigned long chessLockoutUntil = 0; // ignore arcade-button passes until this time, to absorb accidental double-taps
const unsigned long CHESS_PASS_LOCKOUT_MS = 400;

// ---- Hot Potato state ----
const int HP_READY   = 0; // idle, press to arm
const int HP_ARMED   = 1; // hidden countdown running, don't get caught
const int HP_EXPLODED = 2; // showing the result
int hpState = HP_READY;
unsigned long hpArmTime = 0;
unsigned long hpDelay = 0;
const unsigned long HP_MIN_DELAY_MS = 10000;
const unsigned long HP_MAX_DELAY_MS = 60000;
unsigned long hpLastBlinkToggle = 0; // steady LED blink while armed - deliberately NOT tied to time remaining
bool hpBlinkState = false;
const unsigned long HP_BLINK_INTERVAL_MS = 400;
unsigned long hpExplodedAt = 0; // when the bomb went off - drives the auto-reshuffle pause below
const unsigned long HP_EXPLODED_PAUSE_MS = 1000; // how long "BOOM!" stays up before auto-reshuffling

// Category + starting letter challenge (e.g. "Country starting with A"). Rerolled by turning the
// encoder while in HP_READY; fixed once armed. hpCategoryEnabled[] is loaded from/saved to flash
// via the web config page (web_config.ino), same pattern as gameEnabled[].
const int HP_CATEGORY_COUNT = 20;
bool hpCategoryEnabled[HP_CATEGORY_COUNT];
int hpCategory = 0;   // 0..HP_CATEGORY_COUNT-1
int hpLetter = 0;     // 0..25, maps to 'A'..'Z'


// ---- Stopwatch state ----
const int STOPWATCH_READY   = 0; // 0:00, not started
const int STOPWATCH_RUNNING = 1;
const int STOPWATCH_STOPPED = 2; // paused, showing elapsed time
int stopwatchState = STOPWATCH_READY;
unsigned long stopwatchStartMillis = 0;
unsigned long stopwatchElapsedMs = 0; // accumulated time, updated on stop
long stopwatchLapSeconds = -1; // -1 = no lap recorded yet

// ---- Toothbrush state ----
const int TOOTHBRUSH_SELECT_TIME = 0;
const int TOOTHBRUSH_RUNNING     = 1;
const int TOOTHBRUSH_DONE        = 2;
int toothbrushScreenState = TOOTHBRUSH_SELECT_TIME;
int toothbrushMinutes = 2; // 1-5, default 2 (matches the standard dental recommendation)
long toothbrushTotalSeconds = 0;     // set when the run starts, used for the zone math
long toothbrushRemainingSeconds = 0;
bool toothbrushPaused = false;
unsigned long toothbrushLastTick = 0;       // for the 1-second countdown
unsigned long toothbrushLastBrushSound = 0; // for the periodic "scrub" click
bool toothbrushPulseState = false;          // toggles each click, for the LED + active-zone blink + brush scrub
int toothbrushLastZone = -1;                // tracks the previous zone, so a change can be detected and beeped
unsigned int toothbrushFrame = 0;           // counts scrub clicks, drives the foam-bubble positions
const int TOOTHBRUSH_ZONE_COUNT = 6;        // upper left/front/right, then lower left/front/right

// ---- Tetris state ----
// Board is drawn with the display temporarily rotated 90 degrees (see drawTetris*Screen), so the
// physical 128px-long axis becomes the vertical "falling" axis (16 rows) and the 64px axis becomes
// the board's width (8 columns) - a small but proportionally correct playing field for this screen.
const int TETRIS_BOARD_COLS = 8;
const int TETRIS_BOARD_ROWS = 15; // one row shorter than a full 16 to make room for the HUD strip below
const int TETRIS_CELL_SIZE = 8;   // pixels per cell
const int TETRIS_HUD_HEIGHT = 8;  // top strip (score/lines): 8 (HUD) + 15*8 (board) = 128 - exact fit

const int TETRIS_READY     = 0;
const int TETRIS_PLAYING   = 1;
const int TETRIS_GAME_OVER = 2;
int tetrisState = TETRIS_READY;

uint8_t tetrisBoard[TETRIS_BOARD_ROWS][TETRIS_BOARD_COLS]; // 0 = empty, 1 = filled

int tetrisPieceType = 0;     // 0-6: I, O, T, S, Z, J, L
int tetrisPieceRotation = 0; // 0-3
int tetrisPieceRow = 0;      // top-left of the piece's 4x4 bounding box, in board coordinates
int tetrisPieceCol = 0;

unsigned long tetrisLastDropTime = 0;
int tetrisScore = 0;
int tetrisHighScore = 0; // loaded from flash in setup()
int tetrisLinesCleared = 0;

// Tetromino shapes: 7 pieces x 4 rotations, each a 4x4 grid packed into 16 bits (bit index =
// row*4+col, bit set = filled). I and S and Z only have 2 visually distinct states, so their R2/R3
// just repeat R0/R1 - simpler table, and rotating them still "does something" rather than locking up.
const uint16_t TETRIS_SHAPES[7][4] = {
  { 0x00F0, 0x4444, 0x00F0, 0x4444 }, // I
  { 0x0066, 0x0066, 0x0066, 0x0066 }, // O
  { 0x0072, 0x0262, 0x0270, 0x0232 }, // T
  { 0x0036, 0x0462, 0x0036, 0x0462 }, // S
  { 0x0063, 0x0264, 0x0063, 0x0264 }, // Z
  { 0x0071, 0x0226, 0x0470, 0x0322 }, // J
  { 0x0074, 0x0622, 0x0170, 0x0223 }, // L
};

// ---- Star Drop state ----
// Same rotated-screen approach as Tetris: the panel's 128px axis becomes the vertical "falling"
// axis, the 64px axis becomes the 4 catching lanes (16px each).
const int STARDROP_LANES = 4;
const int STARDROP_LANE_WIDTH = 16;  // 4 * 16 = 64, exact fit
const int STARDROP_HUD_HEIGHT = 8;
const int STARDROP_CATCHER_Y = 116;  // top edge of the catcher's zone, near the bottom of the 128px play area
const int STARDROP_MAX_OBJECTS = 6;  // how many can be falling at once
const int STARDROP_START_LIVES = 3;

const int STARDROP_READY     = 0;
const int STARDROP_PLAYING   = 1;
const int STARDROP_GAME_OVER = 2;
int stardropState = STARDROP_READY;

int stardropCatcherLane = 1; // 0-3

bool stardropObjActive[STARDROP_MAX_OBJECTS];
int stardropObjLane[STARDROP_MAX_OBJECTS];
float stardropObjY[STARDROP_MAX_OBJECTS];
int stardropObjType[STARDROP_MAX_OBJECTS]; // 0=star, 1=planet, 2=moon

int stardropScore = 0;
int stardropHighScore = 0; // loaded from flash in setup()
int stardropCatches = 0;
int stardropLives = STARDROP_START_LIVES;

unsigned long stardropLastTick = 0;
unsigned long stardropLastSpawn = 0;

// ---- Snake state ----
// Plays in the normal (unrotated) orientation, unlike Tetris/Star Drop - a wide grid suits the
// panel's natural landscape shape fine, so there's no need for the setRotation(1) trick here.
const int SNAKE_CELL_SIZE = 4;   // pixels per cell
const int SNAKE_HUD_HEIGHT = 16; // content starts just below the standard header/divider at y=14
const int SNAKE_COLS = SCREEN_WIDTH / SNAKE_CELL_SIZE;                        // 32
const int SNAKE_ROWS = (SCREEN_HEIGHT - SNAKE_HUD_HEIGHT) / SNAKE_CELL_SIZE;  // 12
const int SNAKE_MAX_LENGTH = 200; // well under the 32*12=384 total cells - a very long snake already

const int SNAKE_READY     = 0;
const int SNAKE_PLAYING   = 1;
const int SNAKE_PAUSED    = 2;
const int SNAKE_GAME_OVER = 3;
int snakeState = SNAKE_READY;

// heading, as a compass-style index: 0=up, 1=right, 2=down, 3=left. Turning is always relative
// to this (encoder left/right rotates it -1/+1 mod 4) rather than absolute, which is what makes
// "turn left/turn right" a natural fit for a single rotary control. A single 90-degree turn can
// never reverse into the snake's own neck - but two turns applied before the next move happens
// can add up to a 180, so only one turn is accepted per move tick (see snakeTurnedThisTick).
int snakeDirection = 1;
bool snakeTurnedThisTick = false; // caps turning to once per move - see updateSnake()

int snakeRow[SNAKE_MAX_LENGTH]; // index 0 = head
int snakeCol[SNAKE_MAX_LENGTH];
int snakeLength = 0;

int snakeFoodRow = 0;
int snakeFoodCol = 0;

int snakeScore = 0;
int snakeHighScore = 0; // loaded from flash in setup()
unsigned long snakeLastMoveTime = 0;

// ---- Pong state ----
// One player (left paddle, encoder wheel) against the computer (right paddle). 3 lives; +1 point
// per return, +5 for getting the ball past the computer. The ball speeds up on every return and
// the computer gets quicker as the score climbs. Physics runs in fixed 10 ms steps (positions in
// floating-point pixels), the screen redraws at most every PONG_FRAME_MS so the I2C transfer
// (~25 ms per full frame) doesn't starve the encoder polling.
const int PONG_FIELD_TOP = 16;     // just under the standard header/divider at y=14
const int PONG_FIELD_BOTTOM = 63;  // inclusive
const int PONG_PADDLE_H = 12;
const int PONG_PADDLE_W = 2;
const int PONG_PLAYER_X = 1;       // left paddle occupies x=1..2
const int PONG_CPU_X = 125;        // right paddle occupies x=125..126
const int PONG_BALL = 2;           // ball is a 2x2 square
const int PONG_PADDLE_STEP = 4;    // pixels per encoder detent
const int PONG_LIVES = 3;
const unsigned long PONG_STEP_MS = 10;
const unsigned long PONG_FRAME_MS = 33;   // ~30 fps redraw cap
const unsigned long PONG_SERVE_DELAY_MS = 800;
const int PONG_READY = 0;
const int PONG_PLAYING = 1;
const int PONG_PAUSED = 2;
const int PONG_GAME_OVER = 3;
int pongState = PONG_READY;
float pongBallX = 0, pongBallY = 0, pongBallVX = 0, pongBallVY = 0; // px, px per 10 ms step
float pongBallSpeed = 0;
int pongPlayerY = 0;               // top of the player's paddle
float pongCpuY = 0;                // top of the computer's paddle
float pongCpuAimOffset = 0;        // computer's deliberate aiming error, re-rolled on each player return
int pongScore = 0;
int pongHighScore = 0;             // loaded from flash in setup()
int pongLives = PONG_LIVES;
int pongReturns = 0;               // player returns this game, drives the computer's speed
unsigned long pongLastStepTime = 0;
unsigned long pongLastFrameTime = 0;
unsigned long pongServeAt = 0;     // ball waits in the middle until this time after each point
bool pongTestAutopilot = false;    // bench-test only (TT_SCREEN_DUMP builds): paddle follows the ball

// ---- SimpleMorse state ----
// Standard International Morse code for A-Z, as dot/dash strings.
const char* const MORSE_TABLE[26] = {
  ".-", "-...", "-.-.", "-..", ".", "..-.", "--.", "....", "..", ".---", "-.-", ".-..", "--",
  "-.", "---", ".--.", "--.-", ".-.", "...", "-", "..-", "...-", ".--", "-..-", "-.--", "--.."
};

// Each word's total dot/dash count (summed across its letters) was checked to land between
// 10 and 15 - the "10 to 15 presses" requirement - see the constant SIMON_MAX_LENGTH below.
// Every letter's code also fits its on-screen column (128px / letter count) on the Ready screen.
// Short, everyday words (animals, food, nature, toys, home, vehicles...), one pool per language;
// the game uses the pool of the currently selected language. English: 136 words.
const char* const SIMON_WORDS_EN[] = {
  "TIGER", "SNAKE", "PARTY", "BOMB", "CHESS", "DICE", "PLAY", "QUIZ", "LOSE", "BUZZ", "ROLL",
  "PASS", "MORSE", "SIMON", "TETRIS", "DROP", "FISH", "BIRD", "FROG", "BEAR", "LION", "WOLF",
  "DUCK", "COW", "FOX", "OWL", "MOUSE", "HORSE", "SHEEP", "ZEBRA", "PANDA", "KOALA", "CAMEL",
  "SHARK", "WHALE", "CRAB", "SEAL", "LLAMA", "MOON", "SNOW", "WIND", "STORM", "SKY", "LAKE",
  "RIVER", "HILL", "ROCK", "LEAF", "ROSE", "GRASS", "SAND", "BEACH", "WAVE", "FIRE", "APPLE",
  "PEAR", "PLUM", "LEMON", "MANGO", "MELON", "GRAPE", "BERRY", "CAKE", "PASTA", "BREAD", "MILK",
  "SOUP", "RICE", "HONEY", "CANDY", "BALL", "DRUM", "BELL", "BOOK", "DOLL", "CARD", "ROBOT",
  "RADIO", "PIANO", "MUSIC", "SONG", "DANCE", "JUMP", "SWIM", "SING", "DRAW", "PAINT", "HOUSE",
  "HOME", "DOOR", "ROOM", "CHAIR", "TABLE", "LAMP", "PHONE", "BOX", "CUP", "BOWL", "SPOON", "FORK",
  "SOCK", "SHOE", "COAT", "BUS", "TRAIN", "PLANE", "BOAT", "SHIP", "BIKE", "TRUCK", "BLUE", "PINK",
  "GOLD", "GREEN", "WHITE", "FUNNY", "SMILE", "HERO", "MAGIC", "DREAM", "SPACE", "ALIEN", "GHOST",
  "KING", "QUEEN", "CROWN", "FIVE", "ZERO", "LOVE", "HUG", "KISS", "CLUB", "GOAL", "FAST", "SLOW",
  "COLD"
};
// French and Spanish pools follow the same two rules, and only use words that are spelled
// without accents (the Morse alphabet here is plain A-Z, so an accented word would show wrong).
const char* const SIMON_WORDS_FR[] = {
  "TIGRE", "BOMBE", "JOUER", "QUIZ", "PERDU", "GAGNE", "MORSE", "SIMON", "CHAT", "CHIEN", "OISEAU",
  "LAPIN", "OURS", "LION", "LOUP", "VACHE", "RENARD", "MOUTON", "PANDA", "KOALA", "CRABE", "LAMA",
  "SINGE", "TORTUE", "POULE", "LUNE", "PLUIE", "NUAGE", "ORAGE", "CIEL", "LAC", "ARBRE", "ROSE",
  "FLEUR", "HERBE", "SABLE", "PLAGE", "VAGUE", "GLACE", "POMME", "POIRE", "PRUNE", "MANGUE",
  "MELON", "RAISIN", "PAIN", "SOUPE", "OEUF", "SUCRE", "JUS", "LIVRE", "CARTE", "JOUET", "ROBOT",
  "RADIO", "PIANO", "DANSE", "SAUTER", "NAGER", "LIRE", "DESSIN", "MAISON", "PORTE", "TABLE",
  "LAMPE", "TASSE", "BOL", "MANTEAU", "BUS", "TRAIN", "AVION", "ROUGE", "BLEU", "NOIR", "JAUNE",
  "MAGIE", "BISOU", "CLUB", "LOUPE", "JOUR", "SOIR", "HIVER", "ROND", "COEUR", "DOUX", "FORT",
  "KIWI", "OLIVE", "TOMATE", "NOIX", "ORANGE", "STYLO", "GOMME", "PONT", "ROUTE", "VILLE", "PARC",
  "PLUME", "TAPIS", "GUITARE", "JOIE", "CALIN", "DODO", "PAPA", "MAMAN", "TONTON", "BRAS", "PIED",
  "YEUX", "DOIGT"
};
const char* const SIMON_WORDS_ES[] = {
  "TIGRE", "BOMBA", "DADOS", "JUGAR", "GANAR", "MORSE", "SIMON", "PERRO", "LOBO", "PATO", "VACA",
  "CERDO", "ABEJA", "OVEJA", "CEBRA", "PANDA", "KOALA", "FOCA", "LLAMA", "MONO", "CABRA", "SOL",
  "LUNA", "NIEVE", "NUBE", "CIELO", "LAGO", "ROCA", "HOJA", "ROSA", "FLOR", "ARENA", "FUEGO",
  "HIELO", "PERA", "MANGO", "FRESA", "PASTA", "LECHE", "SOPA", "ARROZ", "HUEVO", "DULCE", "QUESO",
  "JUGO", "CARTA", "ROBOT", "RADIO", "PIANO", "BAILE", "NADAR", "CASA", "CAMA", "SILLA", "RELOJ",
  "LLAVE", "CAJA", "BOL", "TENEDOR", "GORRO", "BUS", "BICI", "ROJO", "AZUL", "VERDE", "NEGRO",
  "MAGIA", "REINA", "AMIGO", "BESO", "CLUB", "GOL", "JUEGO", "NOCHE", "TARDE", "FELIZ", "RISA",
  "HOLA", "KIWI", "TOMATE", "OLIVA", "NUEZ", "ERIZO", "MOSCA", "GOMA", "ISLA", "CALLE", "PLUMA",
  "VELA", "TESORO", "BOCA", "DEDO", "OJOS", "NARIZ", "PELO", "DIENTE"
};
const char* const* const SIMON_WORDS_BY_LANG[LANG_COUNT] = {SIMON_WORDS_EN, SIMON_WORDS_FR, SIMON_WORDS_ES};
const int SIMON_WORD_COUNT_BY_LANG[LANG_COUNT] = {
  sizeof(SIMON_WORDS_EN) / sizeof(SIMON_WORDS_EN[0]),
  sizeof(SIMON_WORDS_FR) / sizeof(SIMON_WORDS_FR[0]),
  sizeof(SIMON_WORDS_ES) / sizeof(SIMON_WORDS_ES[0])
};
const int SIMON_MAX_LENGTH = 15; // longest any word's flattened dot/dash sequence can be

const int SIMON_READY     = 0; // showing the chosen word, waiting to start
const int SIMON_PLAYBACK  = 1; // device is playing back the sequence so far (blocking animation)
const int SIMON_INPUT     = 2; // waiting for the player to repeat it via short/long presses
const int SIMON_GAME_OVER = 3; // wrong input - wounded walrus
const int SIMON_COMPLETE  = 4; // player made it through the whole sequence
int simonState = SIMON_READY;

int simonSequence[SIMON_MAX_LENGTH]; // 0 = dot (short press), 1 = dash (long press)
int simonSequenceLength = 0;         // total symbols in the current word
int simonRound = 0;                  // how many symbols the player must currently repeat (1..simonSequenceLength)
int simonInputIndex = 0;             // how many correct presses received so far this round
int simonLastWordIndex = -1;         // never pick the same word twice in a row
char simonWord[16] = "";             // the chosen word, for display
int simonLetterEndIndex[15];         // cumulative symbol count once each letter is complete (parallel to simonWord)
int simonLetterCount = 0;            // how many letters simonLetterEndIndex actually covers
const unsigned long SIMON_DASH_THRESHOLD_MS = 400; // held at least this long = a dash, otherwise a dot

const unsigned long TOOTHBRUSH_BRUSH_INTERVAL_MS = 180; // roughly a "scrub" rhythm

// ---- Trivia state ----
const int TRIVIA_SELECT_CATEGORY = 0;
const int TRIVIA_SELECT_LEVEL    = 1;
const int TRIVIA_PLAYING         = 2;
int triviaScreenState = TRIVIA_SELECT_CATEGORY;

const int TRIVIA_REAL_CATEGORY_COUNT = 8; // Sports, Geography, Science, History, General, Mythology, Art, Animals
const int TRIVIA_CATEGORY_RANDOM = 8;     // sentinel: pulls from any of the 8 real categories
const int TRIVIA_CATEGORY_COUNT = 9;      // the 8 real categories, plus Random
int triviaCategory = 0;
int triviaActiveCategory = 0; // the real category (0-3) the CURRENTLY LOADED question actually belongs to -
                                // always equals triviaCategory, except in Random mode where it varies per question
const int TRIVIA_LEVEL_COUNT = 3; // Junior, Curious, Master
int triviaLevel = 0;
const int TRIVIA_MAX_QUESTIONS = 2500; // upper bound the shuffle array is sized for (covers Random pulling from all 8 categories at once)

int triviaQuestionOrder[TRIVIA_MAX_QUESTIONS]; // shuffled once per round, fixed after that -
                                                 // so turning back always returns to the same question.
                                                 // In Random mode, each entry is packed as (category * 10000 + index).
int triviaQuestionCount = 0;  // how many questions are actually in the current category/level's file
int triviaOrderPosition = 0; // where we are within that shuffled order
char triviaQuestionBuf[110] = ""; // sized for the 5-line display's ~95-char visual capacity, plus margin -
                                    // translations often run longer than the English original
const int TRIVIA_MAX_OPTIONS = 4;
char triviaOptionBuf[TRIVIA_MAX_OPTIONS][40] = {"", "", "", ""}; // shuffled display order - longer than a
                                                                    // row shows (19 chars); overflow scrolls
int triviaOptionCount = 0;      // 2-4 depending on how many non-empty options this question has
int triviaCorrectOption = -1;   // index into triviaOptionBuf that's the correct answer, after shuffling
bool triviaAnswerVisible = false;
bool triviaAnswering = false; // true = within the 5s answer window, LED blinking
bool triviaShowingAnswers = false; // false = Question view, true = Answers view
unsigned long triviaAnswerRevealTime = 0;
int triviaLastBipSecond = 0; // tracks which second-mark within the answer window we last bipped for
const unsigned long TRIVIA_ANSWER_WINDOW_MS = 5000;
bool triviaBlinkState = false;
unsigned long lastTriviaBlinkToggle = 0;

// Text too long for the screen scrolls automatically instead of being cut off (translations often
// run longer than the English): a question needing more than 4 wrapped lines scrolls up a line at a
// time, an answer longer than its 19-character row scrolls sideways a character at a time. Both
// hold still at the start and the end, then loop. Timing restarts whenever the view changes.
const int TRIVIA_QUESTION_VISIBLE_LINES = 4;
const int TRIVIA_QUESTION_CHARS_PER_LINE = 21;
const int TRIVIA_ANSWER_VISIBLE_CHARS = 19;
const unsigned long TRIVIA_SCROLL_HOLD_MS = 1500;      // pause at each end before/after scrolling
const unsigned long TRIVIA_SCROLL_CHAR_MS = 250;       // answers: one character per step
const unsigned long TRIVIA_SCROLL_LINE_MS = 1800;      // questions: one line per step
unsigned long triviaViewShownAt = 0; // reset whenever the Question/Answers view or question changes
long triviaLastScrollFrame = -1;

// volume: 0 = mute, 1 = low, 2 = high. Low is the default.
int volumeLevel = 1;
const int VOLUME_LOW_DUTY  = 40;  // out of 255, quieter
const int VOLUME_HIGH_DUTY = 128; // out of 255, ~full loudness (matches old tone() output)
const int BUZZER_PWM_BITS  = 8;   // 0-255 duty range

bool midpointPlayed = false; // reset each time a run starts, so the midpoint chime only fires once

// short ascending end-of-timer jingle
const int END_MELODY_NOTES[]     = {880, 988, 1175, 1568}; // A5, B5, D6, G6
const int END_MELODY_DURATIONS[] = {120, 120, 120, 220};
const int END_MELODY_LENGTH = 4;

// short "go" jingle when the countdown starts
const int START_MELODY_NOTES[]     = {523, 659, 784}; // C5, E5, G5
const int START_MELODY_DURATIONS[] = {90, 90, 140};
const int START_MELODY_LENGTH = 3;

// short two-tone chime at the halfway point
const int MID_MELODY_NOTES[]     = {784, 659}; // G5, E5
const int MID_MELODY_DURATIONS[] = {100, 140};
const int MID_MELODY_LENGTH = 2;

// short jingle when a reflex round is armed
const int REFLEX_ARM_NOTES[]     = {659, 988}; // E5, B5
const int REFLEX_ARM_DURATIONS[] = {80, 110};
const int REFLEX_ARM_LENGTH = 2;

// single sharp cue played right as the light turns on
const int REFLEX_LIGHT_FREQ = 1800;
const int REFLEX_LIGHT_DURATION_MS = 60;

// short descending "no new record" sound
const int REFLEX_LOSE_NOTES[]     = {392, 311}; // G4, D#4
const int REFLEX_LOSE_DURATIONS[] = {140, 220};
const int REFLEX_LOSE_LENGTH = 2;

// short ascending "new record" fanfare
const int REFLEX_WIN_NOTES[]     = {659, 784, 988, 1319}; // E5, G5, B5, E6
const int REFLEX_WIN_DURATIONS[] = {90, 90, 90, 200};
const int REFLEX_WIN_LENGTH = 4;

// ---- Power management: screen sleeps after inactivity, unless something time-critical is happening ----
const unsigned long SCREEN_TIMEOUT_MS = 5UL * 60UL * 1000UL;      // 5 minutes: OLED off
#ifndef TT_DEEP_SLEEP_TIMEOUT_MS // build-time override, only for bench-testing sleep without waiting 30 min
#define TT_DEEP_SLEEP_TIMEOUT_MS (30UL * 60UL * 1000UL)
#endif
const unsigned long DEEP_SLEEP_TIMEOUT_MS = TT_DEEP_SLEEP_TIMEOUT_MS; // 30 minutes: full chip deep sleep
unsigned long lastActivityTime = 0;
bool screenAsleep = false;

// ---- Explicit function prototypes ----
// Arduino normally auto-generates these, but its scanner can get confused by the CP437 hex-escape
// sequences in the translation strings above (e.g. "Fran\x87" "ais"), silently skipping some
// functions. Declaring them explicitly here avoids relying on that auto-generation at all.
int menuPositionForGame(int gameId);
const char* menuLabelForGame(int gameId);
const char* T(int stringId);
bool registerActivity();
bool isTimeCriticalActive();
void checkScreenSleep();
void checkDeepSleep();
void enterDeepSleep();
void readEncoder();
bool applyEncoderDetent(int direction);
void IRAM_ATTR encoderIsr();
void initGameState(int game);
void confirmMenuSelection();
void playGameSplashScreen(int game);
void drawSplashGameName(const char* name);
void playStarDropSplash();
void playToothbrushSplash();
void drawPixelArt(const char* const* rows, int rowCount, int x, int y, int scale, bool filled, uint16_t color);
void fillEllipseSpans(int cx, int cy, int rx, int ry, uint16_t color);
void drawReflexSplashFrame(int f);
void drawSplashSparkle(int x, int y, int r);
void drawHotPotatoSplashFrame(int f);
void drawSplashClockFace(int cx, int cy, int r, float angle);
void drawChessSplashFrame(int f);
void drawStopwatchSplashFrame(int f);
bool hasAnimatedGameSplash(int game);
int hourglassHalfWidth(int y);
void drawTimerSplashFrame(int f);
void drawSplashDie(int x, int y, int s, int value, bool filled);
void drawDiceSplashFrame(int f);
void drawTriviaSplashFrame(int f);
void drawTetrisSplashFrame(int f);
void snakeArenaTrackPoint(int i, int &x, int &y);
void drawSnakeSplashFrame(int f);
void drawPongSplashFrame(int f);
void drawSimpleMorseSplashFrame(int f);
void playAnimatedGameSplash(int game);
void drawToothbrushSplashBrush(int x, int y);
void drawToothbrushSplashTube(int x, int y);
void drawStarDropSplashRing(int cx, int cy, bool frontHalf, bool gap);
void confirmSettingsSelection();
void confirmLanguageSelection();
void confirmTimerStepSelection();
void confirmDiceType();
void confirmChessStartTime();
long rampedTimeStep(long fromSeconds, int direction);
void confirmChessIncrement();
void toggleChessPause();
void toggleTimerPause();
void doChessPass();
int hpRandomEnabledCategory();
void hpNewCombo();
void hpRerollWithAnimation();
void handleHotPotatoPress();
void updateHotPotato();
void handleStopwatchPress();
void updateStopwatch();
void recordStopwatchLap();
void handleToothbrushPress();
void updateToothbrush();
bool tetrisCollision(int pieceType, int rotation, int row, int col);
void tetrisSpawnPiece();
void playTetrisGameOverAnimation();
void tetrisLockPiece();
void tetrisFlashLines(int* rows, int count);
void tetrisMove(int direction);
void tetrisRotate();
void tetrisHardDrop();
int tetrisGhostRow();
void handleTetrisButtonPress();
void updateTetris();
void stardropStart();
int stardropPointsForType(int type);
void stardropSpawnObject();
void stardropMoveCatcher(int direction);
void handleStarDropButtonPress();
void stardropGameOver();
void playStarDropGameOverAnimation();
void updateStarDrop();
void snakeSpawnFood();
void snakeStart();
void handleSnakeButtonPress();
void snakeGameOver();
void updateSnake();
void simonNewSequence();
void simonPlayback();
void handleSimonButtonPress();
void drawWalrusFace(int cx, int cy, int headR, bool wounded, uint16_t color);
void playWoundedWalrusAnimation();
void drawSimpleMorseIcon(int cx, int cy, int r, uint16_t color);
int toothbrushCurrentZone();
void playToothbrushZoneChangeBeep();
void playToothbrushDoneAnimation();
bool totoroInSilhouette(int x, int y, int dy);
bool totoroMaskAt(int x, int y);
void drawTotoroSilhouette(int dy);
bool totoroLens(int x, float open, int dy, int& top, int& bot, int& div);
void drawTotoroGrin(float open, int glint, int dy);
void drawTotoroSparkle(int x, int y, int r);
void drawTotoro(int dy, float open, int glint, bool blink, bool twitch);
void drawTotoroDoneText();
void drawTotoroDoneFrame(int i);
int totoroDoneFrameCount();
void drawToothbrushSelectScreen();
void drawToothbrushRunningScreen();
void drawTetrisReadyScreen();
int drawRotatedInvertedTitle(const char* title);
int drawRotatedWrappedText(const char* text, int yStart, int lineHeight);
int drawRotatedWrappedTextBottom(const char* text, int lineHeight);
int layoutRotatedWrappedText(const char* text, int yStart, int lineHeight, bool draw);
void drawTetrisPlayScreen();
void drawTetrisGameOverScreen();
void drawStarDropReadyScreen();
void drawStarDropPlayScreen();
void drawStarDropGameOverScreen();
void drawToothbrushIcon(int cx, int cy, int r, uint16_t color);
void drawTetrisIcon(int cx, int cy, int r, uint16_t color);
void drawStarDropIcon(int cx, int cy, int r, uint16_t color);
void drawSnakeIcon(int cx, int cy, int r, uint16_t color);
void drawSnakeScreen();
void pongStart();
void pongServe(int direction);
void handlePongButtonPress();
void updatePong();
void drawPongScreen();
void drawPongIcon(int cx, int cy, int r, uint16_t color);
void drawSimonScreen();
void drawWordWithCode(const char* word, int yTop);
void drawWordProgress(const char* word, int yTop);
void drawStarDropObjectIcon(int cx, int cy, int type, uint16_t color);
void drawStarDropTelescopeIcon(int laneCenterX, int baseY, uint16_t color);
bool loadTriviaQuestion(int category, int index);
void triviaFilePath(int category, char* out, size_t outSize);
int countTriviaQuestions(int category);
void shuffleTriviaOrder();
void loadCurrentTriviaOrderEntry();
void moveTriviaStep(int direction);
void confirmTriviaCategory();
void confirmTriviaLevel();
void handleTriviaButtonPress();
void updateTrivia();
void drawTriviaCategoryScreen();
void drawTriviaLevelScreen();
void drawTriviaPlayScreen();
void drawTriviaIcon(int cx, int cy, int r, uint16_t color);
void invertScreenRegion(int x0, int y0, int x1, int y1);
void drawArrowGlyph(int cx, int cy, uint16_t color, bool pointRight);
int drawWrappedText(const char* text, int yStart, int maxLines, int lineHeight, int skipLines = 0);
int wrappedLineCount(const char* text, int charsPerLine);
int triviaScrollOffset(int overflow, unsigned long stepMs);
bool triviaContentOverflows();
int drawWrappedTextInColumn(const char* text, int xStart, int colWidth, int yStart, int maxLines, int lineHeight);
void drawHotPotatoScreen();
void drawStopwatchScreen();
void drawHotPotatoIcon(int cx, int cy, int r, uint16_t color);
void drawRotateIcon(int cx, int cy, int r, uint16_t color);
void drawStopwatchIcon(int cx, int cy, int r, uint16_t color);
bool tryConfirmSelectionScreens();
bool inGameScreen();
void leaveToMenu();
void openLeaveConfirm();
void confirmLeaveConfirmSelection();
void toggleMenuFromLongPress();
void closeInstructions();
void dispatchButtonShortPress();
void readButton();
void readEncoderButton();
void playNote(int freq, int durationMs);
void startTone(int freq);
void stopTone();
void playEndMelody();
void playStartMelody();
void playMidMelody();
void playArmSound();
void playLightCue();
void playLoseSound();
void playWinSound();
void updateCountdown();
void updateReflexGame();
void updateChessGame();
void playBombAnimation();
int timerEndFrameCount();
void hgPoint(float u, float v, float a, int& x, int& y);
void hgQuad(float u0, float v0, float u1, float v1, float u2, float v2, float u3, float v3, float a);
float hgHalfWidth(float v);
void hgSand(float v0, float v1, float a);
void drawEndHourglass(float a, int topH, int botH);
void drawTimerEndFrame(int i);
void playTimerEndAnimation();
void drawTimerLayout(const char* buf, const char* statusText);
void fillStarburst(int cx, int cy, float R, float rot, int points, float inner, uint16_t color);
void drawExplosionBomb(int fuse, int jx, int* tipX, int* tipY);
void drawBombExplosionFrame(int i);
int bombExplosionFrameCount();
void drawBurst(int cx, int cy, int r);
void playFireworkAnimation();
void fillPolygonXY(const float* xy, int n, uint16_t color);
void drawReflexTrophy(int dy);
void drawReflexRecordFrame(int i);
void playReflexRecordAnimation();
bool splashSkipRequested();
void playSplashScreen();
void handleReflexButtonPress();
int diceFaceSize(int count);
int diceYStart(int count, int faceSize);
void doDiceRoll();
void updateLedBlink();
void render();
void drawMenuScreen();
int listIconSlot(int kind);
void drawListIcon(int kind, int cx, int cy, uint16_t color);
void ensureListIconMetrics();
void drawListIconInBar(int kind, int barTop, uint16_t color);
void drawCenteredAutoFit(const char* text, int y, int maxSize);
void drawTimerScreen();
void drawReflexScreen();
void drawDiceSelectScreen();
void drawDiceScreen();
void drawDieFace(int fx, int fy, int s, int sides, int value, uint16_t color);
void drawChessSetupTimeScreen();
void drawChessSetupIncrementScreen();
void drawChessPlayScreen();
void drawLanguageScreen();
void drawLeaveConfirmScreen();
void drawInstructionsScreen();
void drawSettingsScreen();
void drawTimerStepScreen();
void drawTimerIcon(int cx, int cy, int r, uint16_t color);
void drawReflexIcon(int cx, int cy, int r, uint16_t color);
void drawDiceIcon(int cx, int cy, int r, uint16_t color);
void drawChessIcon(int cx, int cy, int r, uint16_t color);
void drawLanguageIcon(int cx, int cy, int r, uint16_t color);
void drawSettingsIcon(int cx, int cy, int r, uint16_t color);
void drawConfigModeIcon(int cx, int cy, int r, uint16_t color);
void enterConfigMode(); // web_config.ino
void migrateSavedGameIds(); // web_config.ino
void loadMenuOrderFromPrefs(); // web_config.ino
void saveMenuOrderToPrefs(); // web_config.ino
void loadGameEnabledFromPrefs(); // web_config.ino
void loadHpCategoryEnabledFromPrefs(); // web_config.ino
void saveGameEnabledToPrefs(); // web_config.ino
void rebuildVisibleMenu(); // web_config.ino
void drawTimerStepIcon(int cx, int cy, int r, uint16_t color);
void drawGameIcon(int gameIndex, int cx, int cy, int r, uint16_t color);
void drawInstructionsIcon(int cx, int cy, int r, uint16_t color);
void drawThickArcRight(int cx, int cy, int r, int t, float halfDeg, uint16_t color);
void drawThickX(int cx, int cy, int s, int t, uint16_t color);
void drawVolumeIconAt(int x, int y);
void drawVolumeOverlay();

// ---------------- Blank the OLED's own memory before the library switches the panel on ----------------
// After a real power-up (not a deep-sleep wake, where the panel keeps its RAM) the SH1106's display
// RAM holds random data. Adafruit_SH1106G::begin() ends with DISPLAYON without writing the RAM, so
// that noise showed as a flash of random pixels until the splash pushed its first frame (~100ms+).
// Writing zeros to all 8 pages x 132 columns first (the panel is still off, and RAM writes work while
// it's off) means the panel turns on black. Raw I2C because the library isn't initialized yet.
void clearOledRamBeforeInit() {
  Wire.beginTransmission(OLED_I2C_ADDR);
  Wire.write(0x00);                    // control byte: commands follow
  Wire.write(SH110X_DISPLAYOFF);       // in case it was left on (e.g. a reset while running)
  Wire.endTransmission();
  for (uint8_t page = 0; page < 8; page++) {
    Wire.beginTransmission(OLED_I2C_ADDR);
    Wire.write(0x00);                  // commands
    Wire.write(0xB0 | page);           // page address
    Wire.write(0x00);                  // column low nibble = 0
    Wire.write(0x10);                  // column high nibble = 0
    Wire.endTransmission();
    for (int col = 0; col < 132; col += 22) { // SH1106 RAM is 132 columns wide (panel shows 128)
      Wire.beginTransmission(OLED_I2C_ADDR);
      Wire.write(0x40);                // control byte: display data follows
      for (int i = 0; i < 22; i++) Wire.write(0x00);
      Wire.endTransmission();
    }
  }
}

void setup() {
  // After a deep-sleep wake the button pin is still owned by the LP-IO block (see enterDeepSleep) -
  // hand it back to the normal GPIO matrix before configuring it, or digitalRead() can't see it.
  rtc_gpio_hold_dis((gpio_num_t)digitalPinToGPIONumber(BUTTON_PIN));
  rtc_gpio_deinit((gpio_num_t)digitalPinToGPIONumber(BUTTON_PIN));
  pinMode(BUTTON_PIN, INPUT_PULLUP);
  pinMode(BUTTON_LED, OUTPUT);
  ledcAttach(BUZZER_PIN, 2000, BUZZER_PWM_BITS); // attach buzzer to LEDC so duty (volume) is controllable
  pinMode(ENCODER_CLK, INPUT_PULLUP);
  pinMode(ENCODER_DT, INPUT_PULLUP);
  pinMode(ENCODER_SW, INPUT_PULLUP);

  digitalWrite(BUTTON_LED, LOW);
  encoderClkGpio = (gpio_num_t)digitalPinToGPIONumber(ENCODER_CLK);
  encoderDtGpio = (gpio_num_t)digitalPinToGPIONumber(ENCODER_DT);
  encoderLastAB = (gpio_get_level(encoderClkGpio) << 1) | gpio_get_level(encoderDtGpio);
  attachInterrupt(digitalPinToInterrupt(ENCODER_CLK), encoderIsr, CHANGE);
  attachInterrupt(digitalPinToInterrupt(ENCODER_DT), encoderIsr, CHANGE);

  Serial.begin(115200);
  randomSeed(esp_random() ^ micros()); // hardware RNG: micros() alone is nearly identical every boot,
                                       // which replayed the same "random" words, dice, delays... each time

  prefs.begin("gametimer", false);
  currentLanguage = constrain((int)prefs.getUChar("lang", LANG_EN), 0, LANG_COUNT - 1);
  currentTimerStepIndex = constrain((int)prefs.getUChar("step", TIMER_STEP_DEFAULT_INDEX), 0, TIMER_STEP_OPTION_COUNT - 1);
  migrateSavedGameIds();    // web_config.ino - one-time conversion of settings saved by older firmware (idVer)
  loadMenuOrderFromPrefs(); // web_config.ino - fills MENU_ORDER from flash, or DEFAULT_MENU_ORDER if unset/invalid
  loadGameEnabledFromPrefs(); // web_config.ino - fills gameEnabled[] from flash, or the fresh-box defaults if unset
  rebuildVisibleMenu(); // web_config.ino - filters MENU_ORDER by gameEnabled into visibleMenuOrder
  stardropHighScore = prefs.getUShort("sdHigh", 0);
  tetrisHighScore = prefs.getUShort("ttHigh", 0);
  snakeHighScore = prefs.getUShort("skHigh", 0);
  pongHighScore = prefs.getUShort("pgHigh", 0);
  loadHpCategoryEnabledFromPrefs(); // web_config.ino

  long defaultTimerSeconds = constrain((long)prefs.getUShort("deftime", (uint16_t)DEFAULT_TIME), MIN_TIME, MAX_TIME);
  presetTime = defaultTimerSeconds;
  remainingTime = defaultTimerSeconds;
  runStartTime = defaultTimerSeconds;

  bool fsOk = LittleFS.begin(true); // true = format if mount fails (e.g. first run)
  if (!fsOk) {
    Serial.println("LittleFS mount failed - trivia questions won't load. Did you upload the data folder?");
  }
  // Since v1.0.0 the Remote Config page is built into the firmware (config_html.h); the copy older
  // boxes have on LittleFS is no longer used - remove it to free the space.
  if (fsOk && LittleFS.exists("/config.html")) LittleFS.remove("/config.html");

  Wire.begin(D4, D5); // SDA, SCL
  clearOledRamBeforeInit(); // no random-pixel flash on power-up - see the function
  bool oledOk = display.begin(OLED_I2C_ADDR, true);
  if (!oledOk) {
    Serial.println("OLED not found - check wiring/address");
  }

  // One-line boot summary on USB serial - lets a connected computer confirm a healthy boot
  // (and that the trivia data / config page are present) without looking at the screen.
  Serial.printf("[boot] Tiger Timer v%s - reset=%d wake=%d, OLED %s, LittleFS %s (%u/%u KB used), sports_junior.csv %s, lang=%d\n",
                FW_VERSION,
                (int)esp_reset_reason(), (int)esp_sleep_get_wakeup_cause(),
                oledOk ? "ok" : "MISSING", fsOk ? "ok" : "FAILED",
                fsOk ? (unsigned)(LittleFS.usedBytes() / 1024) : 0u, fsOk ? (unsigned)(LittleFS.totalBytes() / 1024) : 0u,
                (fsOk && LittleFS.exists("/sports_junior.csv")) ? "present" : "missing",
                currentLanguage);
  display.setRotation(0);
  display.cp437(true); // use the corrected CP437 character mapping, needed for accented characters

  playSplashScreen(); // returns early if the arcade button is pressed during it, to skip straight in

  // ---- Startup behavior: go to the menu, or boot straight into a chosen game ----
  uint8_t startMode = prefs.getUChar("startMode", 0); // 0 = menu (default), 1 = specific game
  uint8_t startGame = prefs.getUChar("startGame", (uint8_t)GAME_TIMER);
  bool validStartGame = ((int)startGame >= 0 && (int)startGame < GAME_COUNT && gameEnabled[startGame]);
  if (startMode == 1 && validStartGame) {
    currentGame = (int)startGame;
    inMenu = false;
    initGameState(currentGame);
    if (currentGame == GAME_HOTPOTATO) {
      hpRerollWithAnimation(); // first combo drawn with the same shuffle animation as a manual reroll
    }
  } else {
    inMenu = true;
    menuSelection = 0; // highlight the first entry in the list, not wherever Timer happens to be
  }

  lastActivityTime = millis();
  render();
}

#ifdef TT_SCREEN_DUMP
// ---------------- Bench-test only (never in a normal build): drive the toothbrush screen over
// USB serial and dump the OLED buffer as text, so a computer can check the drawing without
// eyes on the panel. t = open Toothbrush, p = arcade press, f = skip 20s ahead, d = dump,
// m = list the visible menu, w = 10 SimpleMorse word picks,
// L = cycle the language in RAM only (not saved), P = open Pong, u/j = paddle up/down,
// s = Pong state, A = Pong autopilot on/off, Z = clear the Pong high score. ----------------
void testSerialCommands() {
  while (Serial.available()) {
    char c = Serial.read();
    if (c == 't') { inMenu = false; currentGame = GAME_TOOTHBRUSH; initGameState(GAME_TOOTHBRUSH); render(); }
    else if (c == 'p') { if (currentGame == GAME_TOOTHBRUSH) handleToothbrushPress(); else dispatchButtonShortPress(); }
    else if (c == 'R') { inMenu = false; currentGame = GAME_STARDROP; initGameState(GAME_STARDROP); render(); }
    else if (c == 'T') { inMenu = false; currentGame = GAME_TETRIS; initGameState(GAME_TETRIS); render(); }
    else if (c == 'X') { static int bombFxFrame = 0; drawBombExplosionFrame(bombFxFrame); display.display(); Serial.printf("[bombfx] frame %d\n", bombFxFrame); bombFxFrame = (bombFxFrame + 1) % bombExplosionFrameCount(); }
    else if (c == 'V') { volumeLevel = (volumeLevel + 1) % 3; drawVolumeOverlay(); Serial.printf("[vol] %d (RAM only)\n", volumeLevel); }
    else if (c == 'Y') { static int timerEndFrame = 0; drawTimerEndFrame(timerEndFrame); display.display(); Serial.printf("[timerend] frame %d\n", timerEndFrame); timerEndFrame = (timerEndFrame + 1) % timerEndFrameCount(); }
    else if (c == 'O') { static int totoroFrame = 0; unsigned long t0 = micros(); drawTotoroDoneFrame(totoroFrame); unsigned long dt = micros() - t0; display.display(); Serial.printf("[totoro] frame %d drawn in %lu us\n", totoroFrame, dt); totoroFrame = (totoroFrame + 1) % totoroDoneFrameCount(); }
    else if (c == 'W') { static int recFrame = 0; drawReflexRecordFrame(recFrame); display.display(); Serial.printf("[record] frame %d\n", recFrame); recFrame = (recFrame + 1) % 13; }
    else if (c == 'I') { display.clearDisplay(); drawInstructionsScreen(); display.display(); }
    else if (c == 'L') { currentLanguage = (currentLanguage + 1) % LANG_COUNT; Serial.printf("[lang] %d (RAM only)\n", currentLanguage); }
    else if (c == 'J') { display.clearDisplay(); drawReflexSplashFrame(4); drawSplashGameName(T(STR_MENU_REFLEX)); display.display(); } // Reflex splash, fully pressed
    else if (c == 'H') { stardropHighScore = 1234; tetrisHighScore = 1234; render(); } // RAM only - tests the wrapped score line
    else if (c == 'g' || c == 'h' || c == 'k' || c == 'c') { playGameSplashScreen(c == 'g' ? GAME_REFLEX : c == 'h' ? GAME_HOTPOTATO : c == 'k' ? GAME_CHESS : GAME_STOPWATCH); }
    else if (c == 'G') { // cycle through the newest animated splashes
      static const int GAMES[] = {GAME_TIMER, GAME_DICE, GAME_TRIVIA, GAME_TETRIS, GAME_SNAKE, GAME_PONG, GAME_SIMPLEMORSE};
      static int next = 0;
      playGameSplashScreen(GAMES[next]);
      next = (next + 1) % 7;
    }
    else if (c == 'n') { if (inMenu) { menuSelection = (menuSelection + 1) % visibleMenuCount; render(); } }
    else if (c == 'B') { playGameSplashScreen(GAME_TOOTHBRUSH); }
    else if (c == 'Q') { playGameSplashScreen(GAME_STARDROP); }
    else if (c == 'P') { inMenu = false; currentGame = GAME_PONG; initGameState(GAME_PONG); render(); }
    else if (c == 'u' || c == 'j') { // Pong paddle up / down one detent
      if (currentGame == GAME_PONG && pongState == PONG_PLAYING)
        pongPlayerY = constrain(pongPlayerY + (c == 'j' ? 1 : -1) * PONG_PADDLE_STEP, PONG_FIELD_TOP, PONG_FIELD_BOTTOM - PONG_PADDLE_H + 1);
    }
    else if (c == 's') { // Pong state snapshot
      Serial.printf("[pong] state=%d score=%d lives=%d high=%d ball=(%.1f,%.1f) v=(%.2f,%.2f) player=%d cpu=%.1f returns=%d\n",
        pongState, pongScore, pongLives, pongHighScore, pongBallX, pongBallY, pongBallVX, pongBallVY, pongPlayerY, pongCpuY, pongReturns);
    }
    else if (c == 'Z') { pongHighScore = 0; prefs.putUShort("pgHigh", 0); Serial.println("[pong] high score cleared"); }
    else if (c == 'e') { Serial.printf("[enc] clk=%d dt=%d last=%d acc=%d pending=%d paddle=%d\n", digitalRead(ENCODER_CLK), digitalRead(ENCODER_DT), encoderLastAB, encoderStepAcc, encoderPendingDetents, pongPlayerY); }
    else if (c == 'A') { // autopilot toggle: Pong paddle tracks the ball by itself (for soak-testing physics)
      pongTestAutopilot = !pongTestAutopilot;
      Serial.printf("[pong] autopilot %s\n", pongTestAutopilot ? "on" : "off");
    }
    else if (c == 'f') { toothbrushRemainingSeconds = max(1L, toothbrushRemainingSeconds - 20); toothbrushLastTick = millis() - 1000; }
    else if (c == 'm') { // visible menu, in order, with the ids behind it
      Serial.print("[menu]");
      for (int i = 0; i < visibleMenuCount; i++) Serial.printf(" %d:%s", visibleMenuOrder[i],
        visibleMenuOrder[i] == MENU_SETTINGS ? "Settings" : visibleMenuOrder[i] == MENU_INSTRUCTIONS ? "Instructions" : menuLabelForGame(visibleMenuOrder[i]));
      Serial.printf(" | idVer=%d startMode=%d startGame=%d\n", prefs.getUChar("idVer", 1), prefs.getUChar("startMode", 0), prefs.getUChar("startGame", 0));
    }
    else if (c == 'w') { // 10 SimpleMorse word picks, to check variety across boots
      Serial.print("[words]");
      for (int i = 0; i < 10; i++) { simonNewSequence(); Serial.printf(" %s(%d)", simonWord, simonSequenceLength); }
      Serial.println();
    }
    else if (c == 'L') { currentLanguage = (currentLanguage + 1) % LANG_COUNT; simonLastWordIndex = -1; Serial.printf("[lang] %d (RAM only, not saved)\n", currentLanguage); }
    else if (c == 'd') {
      Serial.println("[dump begin]");
      for (int y = 0; y < SCREEN_HEIGHT; y++) {
        char line[SCREEN_WIDTH + 1];
        for (int x = 0; x < SCREEN_WIDTH; x++) line[x] = display.getPixel(x, y) ? '#' : '.';
        line[SCREEN_WIDTH] = 0;
        Serial.println(line);
      }
      Serial.println("[dump end]");
    }
  }
}
#endif

void loop() {
#ifdef TT_SCREEN_DUMP
  testSerialCommands();
#endif
  readEncoder();
  readButton();
  readEncoderButton();

  if (!inMenu && currentGame == GAME_TIMER) {
    updateCountdown();
    updateLedBlink();
  }
  if (!inMenu && currentGame == GAME_REFLEX) {
    updateReflexGame();
  }
  if (!inMenu && currentGame == GAME_CHESS) {
    updateChessGame();
  }
  if (!inMenu && currentGame == GAME_HOTPOTATO) {
    updateHotPotato();
  }
  if (!inMenu && currentGame == GAME_STOPWATCH) {
    updateStopwatch();
  }
  if (!inMenu && currentGame == GAME_TRIVIA) {
    updateTrivia();
  }
  if (!inMenu && currentGame == GAME_TOOTHBRUSH) {
    updateToothbrush();
  }
  if (!inMenu && currentGame == GAME_TETRIS) {
    updateTetris();
  }
  if (!inMenu && currentGame == GAME_STARDROP) {
    updateStarDrop();
  }
  if (!inMenu && currentGame == GAME_PONG) {
    updatePong();
  }
  if (!inMenu && currentGame == GAME_SNAKE) {
    updateSnake();
  }

  checkScreenSleep();
  checkDeepSleep();
}

// ---------------- Power management: call whenever real user input happens. Returns true if this
// input just woke a sleeping screen - input handlers then swallow that gesture, so a press or turn
// made on a dark screen only wakes it instead of also doing something the user couldn't see. ----------------
bool registerActivity() {
  lastActivityTime = millis();
  if (screenAsleep) {
    display.oled_command(SH110X_DISPLAYON);
    screenAsleep = false;
    return true;
  }
  return false;
}

// ---------------- Power management: true while a countdown, an armed reflex round, or a running chess clock is in progress ----------------
bool isTimeCriticalActive() {
  return (currentGame == GAME_TIMER && running && !timerPaused) ||
         (currentGame == GAME_REFLEX && reflexState != REFLEX_READY) ||
         (currentGame == GAME_CHESS && chessScreenState == CHESS_PLAYING && chessStarted && !chessPaused) ||
         (currentGame == GAME_HOTPOTATO && hpState == HP_ARMED) ||
         (currentGame == GAME_STOPWATCH && stopwatchState == STOPWATCH_RUNNING) ||
         (currentGame == GAME_TRIVIA && triviaAnswering) ||
         (currentGame == GAME_TOOTHBRUSH && toothbrushScreenState == TOOTHBRUSH_RUNNING && !toothbrushPaused) ||
         (currentGame == GAME_TETRIS && tetrisState == TETRIS_PLAYING) ||
         (currentGame == GAME_STARDROP && stardropState == STARDROP_PLAYING) ||
         (currentGame == GAME_SNAKE && snakeState == SNAKE_PLAYING) ||
         (currentGame == GAME_PONG && pongState == PONG_PLAYING) ||
         (currentGame == GAME_SIMPLEMORSE && simonState == SIMON_INPUT);
}

// ---------------- Power management: sleeps the OLED after 5 minutes idle, unless something time-critical is running ----------------
void checkScreenSleep() {
  if (!screenAsleep && !isTimeCriticalActive() && (millis() - lastActivityTime >= SCREEN_TIMEOUT_MS)) {
    display.oled_command(SH110X_DISPLAYOFF);
    screenAsleep = true;
  }
}

// ---------------- Power management: after 30 minutes idle, puts the whole chip into deep sleep.
// Wakes instantly on an arcade button press (D1) via ext1 - confirmed as a working wake pin on this
// board. Deep sleep does not affect USB charging, since the XIAO's on-board charge chip is separate
// hardware from the ESP32C6 and runs independently of its sleep state.
// NOTE: this is effectively a reboot on wake - setup() runs again, all normal RAM state resets to
// defaults (session high scores etc.), same as any power-up. Settings saved to flash (language,
// timer step) are unaffected either way. ----------------
void checkDeepSleep() {
  if (!isTimeCriticalActive() && (millis() - lastActivityTime >= DEEP_SLEEP_TIMEOUT_MS)) {
    enterDeepSleep();
  }
}

void enterDeepSleep() {
  digitalWrite(BUTTON_LED, LOW);
  display.oled_command(SH110X_DISPLAYOFF);
  prefs.end();

  // ext1 hands the pin over to the low-power (RTC/LP) IO block for sleep, which has its OWN
  // pull-up/pull-down - the pinMode(INPUT_PULLUP) set in setup() is the digital one and doesn't
  // carry over. Without enabling the LP pull-up here the pin floats, reads LOW, and the chip
  // wakes (= reboots, chime and all) the instant it goes to sleep. The RTC_PERIPH domain stays
  // on so that pull-up stays powered through sleep.
  gpio_num_t wakePin = (gpio_num_t)digitalPinToGPIONumber(BUTTON_PIN);
  rtc_gpio_init(wakePin);
  rtc_gpio_set_direction(wakePin, RTC_GPIO_MODE_INPUT_ONLY);
  rtc_gpio_pulldown_dis(wakePin);
  rtc_gpio_pullup_en(wakePin);
  esp_sleep_pd_config(ESP_PD_DOMAIN_RTC_PERIPH, ESP_PD_OPTION_ON);
  esp_sleep_enable_ext1_wakeup(1ULL << wakePin, ESP_EXT1_WAKEUP_ANY_LOW);
#ifdef TT_SLEEP_TEST_TIMER_WAKE_S // bench-test only: also wake on a timer, so a test can confirm the chip stays asleep then comes back
  esp_sleep_enable_timer_wakeup((uint64_t)TT_SLEEP_TEST_TIMER_WAKE_S * 1000000ULL);
#endif
  esp_deep_sleep_start();
}

// ---------------- Encoder interrupt: Gray-code quadrature decoder. One detent = one full cycle
// 3 -> 1 -> 0 -> 2 -> 3 (clockwise; the reverse is counter-clockwise), counted when the contacts
// come back to rest at 3 having moved at least half a cycle in one direction. Bounce on one
// contact alternates +1/-1 and nets to zero; an illegal jump (both bits changed) counts nothing. ----------------
void IRAM_ATTR encoderIsr() {
  static const int8_t QUARTER_STEP[16] = {
    //  to: 0   1   2   3     from:
            0, -1, +1,  0,  // 0
           +1,  0,  0, -1,  // 1
           -1,  0,  0, +1,  // 2
            0, +1, -1,  0   // 3
  };
  uint8_t ab = (gpio_get_level(encoderClkGpio) << 1) | gpio_get_level(encoderDtGpio);
  if (ab == encoderLastAB) return;
  encoderStepAcc += QUARTER_STEP[(encoderLastAB << 2) | ab];
  encoderLastAB = ab;
  if (ab == 3) {
    if (encoderStepAcc >= 2) encoderPendingDetents++;
    else if (encoderStepAcc <= -2) encoderPendingDetents--;
    encoderStepAcc = 0;
  }
}

// ---------------- Encoder: hold the SW button and turn for volume; otherwise navigates whichever screen is active ----------------
void readEncoder() {
  // take every detent the interrupt has counted since the last pass (several, after a blocking
  // screen transfer or sound during a fast spin)
  noInterrupts();
  int pending = encoderPendingDetents;
  encoderPendingDetents = 0;
  interrupts();
  if (pending == 0) return;
  if (registerActivity()) return; // these detents only woke the screen - don't also act on them

  if (currentGame == GAME_PONG && !inMenu && !inLeaveConfirm && !inInstructions && swState != LOW) {
    // the whole batch moves the paddle at once - updatePong() redraws at its own frame rate, so a
    // fast spin isn't slowed down by a full screen transfer on every detent. Clockwise = down.
    if (pongState == PONG_PLAYING) {
      pongPlayerY = constrain(pongPlayerY + pending * PONG_PADDLE_STEP, PONG_FIELD_TOP, PONG_FIELD_BOTTOM - PONG_PADDLE_H + 1);
    }
    return;
  }

  int direction = (pending > 0) ? 1 : -1; // +1 clockwise, -1 counter-clockwise
  bool needsRender = false;
  for (int i = 0; i < abs(pending); i++) {
    needsRender = applyEncoderDetent(direction) || needsRender;
  }
  if (needsRender) render(); // one redraw for the whole batch
}

// ---------------- Encoder: one detent's worth of action on whichever screen is active. Returns
// true when the caller still has to render(); branches that already draw themselves return false. ----------------
bool applyEncoderDetent(int direction) {
  {
    if (swState == LOW && !swLongFired) {
      // encoder button is currently held (and hasn't already opened the menu via long-press) -
      // this turn adjusts volume instead of anything else, and claims the hold so releasing it
      // afterward doesn't also fire a click action
      volumeLevel = constrain(volumeLevel + direction, 0, 2);
      ledcWrite(BUZZER_PIN, 0); // silence anything currently sounding
      swClaimedByVolume = true;
      drawVolumeOverlay(); // full-screen, live - readEncoderButton() restores the normal screen on release
      return false;
    } else if (inLeaveConfirm) {
      leaveConfirmSelection = 1 - leaveConfirmSelection; // only Yes/No - either direction toggles
    } else if (inInstructions) {
      // static screen, nothing to select - rotation has no effect
    } else if (inLanguageSelect) {
      currentLanguage = constrain(currentLanguage + direction, 0, LANG_COUNT - 1);
    } else if (inTimerStepSelect) {
      currentTimerStepIndex = constrain(currentTimerStepIndex + direction, 0, TIMER_STEP_OPTION_COUNT - 1);
    } else if (inSettingsMenu) {
      settingsSelection = constrain(settingsSelection + direction, 0, SETTINGS_COUNT - 1);
    } else if (inMenu) {
      menuSelection = constrain(menuSelection + direction, 0, visibleMenuCount - 1);
    } else if (currentGame == GAME_TIMER) {
      if (!running) {
        long step = (TIMER_STEP_OPTIONS[currentTimerStepIndex] == TIMER_STEP_AUTO) ? rampedTimeStep(presetTime, direction) : TIMER_STEP_OPTIONS[currentTimerStepIndex];
        presetTime = constrain(presetTime + direction * step, MIN_TIME, MAX_TIME);
        remainingTime = presetTime; // preview the new setting on screen
      }
      // while running (or paused): rotation has no effect, to avoid accidentally
      // changing the time mid-game
    } else if (currentGame == GAME_DICE) {
      if (diceScreenState == DICE_SELECT_TYPE) {
        currentDieIndex = constrain(currentDieIndex + direction, 0, DICE_TYPE_COUNT - 1);
      } else {
        diceCount = constrain(diceCount + direction, 1, MAX_DICE_COUNT);
      }
    } else if (currentGame == GAME_CHESS) {
      if (chessScreenState == CHESS_SETUP_TIME) {
        long step = rampedTimeStep(chessStartSeconds, direction);
        chessStartSeconds = constrain(chessStartSeconds + direction * step, CHESS_START_MIN_SECONDS, CHESS_START_MAX_SECONDS);
      } else if (chessScreenState == CHESS_SETUP_INCREMENT) {
        chessIncrementSeconds = constrain(chessIncrementSeconds + direction * 10, 0, 60);
      }
      // CHESS_PLAYING / CHESS_GAME_OVER: rotation has no effect
    } else if (currentGame == GAME_TRIVIA) {
      if (triviaScreenState == TRIVIA_SELECT_CATEGORY) {
        triviaCategory = constrain(triviaCategory + direction, 0, TRIVIA_CATEGORY_COUNT - 1);
      } else if (triviaScreenState == TRIVIA_SELECT_LEVEL) {
        triviaLevel = constrain(triviaLevel + direction, 0, TRIVIA_LEVEL_COUNT - 1);
      } else if (triviaScreenState == TRIVIA_PLAYING) {
        moveTriviaStep(direction); // Question <-> Answers <-> next/previous Question, one step per detent
        return false; // moveTriviaStep() already renders and plays its own confirmation sound
      }
    } else if (currentGame == GAME_TOOTHBRUSH && toothbrushScreenState == TOOTHBRUSH_SELECT_TIME) {
      toothbrushMinutes = constrain(toothbrushMinutes + direction, 1, 5);
    } else if (currentGame == GAME_TETRIS) {
      tetrisMove(direction); // already renders itself only if the move was actually valid
      return false;
    } else if (currentGame == GAME_STARDROP) {
      stardropMoveCatcher(direction); // already renders itself
      return false;
    } else if (currentGame == GAME_SNAKE && snakeState == SNAKE_PLAYING) {
      if (!snakeTurnedThisTick) {
        snakeDirection = ((snakeDirection + direction) % 4 + 4) % 4; // relative turn: +1 = right, -1 = left
        snakeTurnedThisTick = true;
      }
    } else if (currentGame == GAME_PONG) {
      return false; // handled as a batch in readEncoder()
    } else if (currentGame == GAME_HOTPOTATO && hpState == HP_READY) {
      hpRerollWithAnimation(); // blocking - already renders itself throughout
      return false;
    } else if (currentGame == GAME_HOTPOTATO && hpState == HP_EXPLODED) {
      hpState = HP_READY;
      hpRerollWithAnimation(); // skips straight past the post-explosion pause in updateHotPotato()
      digitalWrite(BUTTON_LED, LOW);
      return false;
    }
    // GAME_REFLEX, GAME_STOPWATCH: encoder rotation has no effect

    return true;
  }
}

// ---------------- Menu: confirms the highlighted entry - a game, or opens the settings submenu ----------------
// ---------------- Shared: resets a game to its just-opened state - the same reset whether you
// reached it by picking it from the menu, or by booting straight into it (the "Start with a
// specific game" startup option in Config Mode uses this too). Does NOT touch currentGame/inMenu
// or call render() - callers handle those. ----------------
void initGameState(int game) {
  if (game == GAME_REFLEX) {
    reflexState = REFLEX_READY;
    falseStartUntil = 0;
    digitalWrite(BUTTON_LED, LOW);
  } else if (game == GAME_DICE) {
    diceScreenState = DICE_SELECT_TYPE;
    diceResultCount = 0;
  } else if (game == GAME_CHESS) {
    chessScreenState = CHESS_SETUP_TIME;
    chessPaused = false;
    digitalWrite(BUTTON_LED, LOW);
  } else if (game == GAME_HOTPOTATO) {
    hpState = HP_READY;
    hpNewCombo();
    volumeLevel = 2; // make sure the explosion is actually heard - this is the one game where that really matters
    digitalWrite(BUTTON_LED, LOW);
  } else if (game == GAME_STOPWATCH) {
    stopwatchState = STOPWATCH_READY;
    stopwatchElapsedMs = 0;
    stopwatchLapSeconds = -1;
  } else if (game == GAME_TRIVIA) {
    triviaScreenState = TRIVIA_SELECT_CATEGORY;
    triviaAnswering = false;
    triviaAnswerVisible = false;
    digitalWrite(BUTTON_LED, LOW);
  } else if (game == GAME_TOOTHBRUSH) {
    toothbrushScreenState = TOOTHBRUSH_SELECT_TIME;
    toothbrushPaused = false;
    digitalWrite(BUTTON_LED, LOW);
  } else if (game == GAME_TETRIS) {
    tetrisState = TETRIS_READY;
  } else if (game == GAME_STARDROP) {
    stardropState = STARDROP_READY;
  } else if (game == GAME_PONG) {
    pongState = PONG_READY;
  } else if (game == GAME_SNAKE) {
    snakeState = SNAKE_READY;
  } else if (game == GAME_SIMPLEMORSE) {
    simonState = SIMON_READY;
    simonRound = 0;
    simonNewSequence();
  }
}

void confirmMenuSelection() {
  int selected = visibleMenuOrder[menuSelection];

  if (selected == MENU_SETTINGS) {
    inMenu = false;
    inSettingsMenu = true;
    render();
    return;
  }

  if (selected == MENU_INSTRUCTIONS) {
    inMenu = false;
    inInstructions = true;
    render();
    return;
  }

  currentGame = selected;
  inMenu = false;
  initGameState(currentGame);
  playGameSplashScreen(currentGame);
  if (currentGame == GAME_HOTPOTATO) {
    hpRerollWithAnimation(); // first combo drawn with the same shuffle animation as a manual reroll
  }
  render();
}

// ---------------- Brief (1s) splash shown right after picking a game from the menu: its icon big
// on the left, the game's name next to it. Blocking, like the sketch's other short animations. ----------------
void playGameSplashScreen(int game) {
  if (game == GAME_STARDROP) { // has its own animated scene instead of the big menu icon
    playStarDropSplash();
    return;
  }
  if (game == GAME_TOOTHBRUSH) {
    playToothbrushSplash();
    return;
  }
  if (hasAnimatedGameSplash(game)) {
    playAnimatedGameSplash(game);
    return;
  }
  display.clearDisplay();
  display.setTextColor(SH110X_WHITE);

  // logo up top, similar scale to the boot splash's tiger bitmap
  int iconCx = SCREEN_WIDTH / 2;
  int iconCy = 22;
  int iconR = 20;
  drawGameIcon(game, iconCx, iconCy, iconR, SH110X_WHITE);

  drawSplashGameName(menuLabelForGame(game));
  display.display();
  delay(1000);
}

// ---------------- Per-game splash: the game's name along the bottom, in the same Press Start 2P font
// as the boot splash's TIGER/TIMER wordmark. At its native 8px size this comfortably fits every
// current game name on one line (that's what was getting cut off before, e.g. Spanish
// "Temporizador") - the wrap below is just a safety net. ----------------
void drawSplashGameName(const char* name) {
  display.setFont(&PressStart2P8pt);
  display.setTextSize(1);

  int16_t x1, y1;
  uint16_t w, h;
  display.getTextBounds(name, 0, 0, &x1, &y1, &w, &h);

  if ((int)w <= SCREEN_WIDTH - 4) {
    display.setCursor((SCREEN_WIDTH - (int)w) / 2 - x1, 48 - y1);
    display.print(name);
  } else {
    // split at whichever space sits closest to the middle - not currently needed by any game
    // name, but keeps a very long future name readable instead of overflowing
    String s(name);
    int mid = s.length() / 2;
    int splitAt = -1;
    for (int i = 0; i < (int)s.length(); i++) {
      if (s[i] == ' ' && (splitAt < 0 || abs(i - mid) < abs(splitAt - mid))) splitAt = i;
    }
    String line1 = (splitAt >= 0) ? s.substring(0, splitAt) : s;
    String line2 = (splitAt >= 0) ? s.substring(splitAt + 1) : "";

    uint16_t w1, h1, w2, h2;
    display.getTextBounds(line1.c_str(), 0, 0, &x1, &y1, &w1, &h1);
    display.setCursor((SCREEN_WIDTH - (int)w1) / 2 - x1, 44 - y1);
    display.print(line1);
    if (line2.length() > 0) {
      display.getTextBounds(line2.c_str(), 0, 0, &x1, &y1, &w2, &h2);
      display.setCursor((SCREEN_WIDTH - (int)w2) / 2 - x1, 56 - y1);
      display.print(line2);
    }
  }

  display.setFont(); // back to the normal built-in font for every other screen
}

// ---------------- Pixel art: rows of '#' (lit) and '.' (unlit), drawn at a whole-number scale.
// filled=true lights every pixel between the first and last '#' of each row - a solid silhouette
// of an outline drawing (used for the black king on the Chess Clock splash). ----------------
void drawPixelArt(const char* const* rows, int rowCount, int x, int y, int scale, bool filled, uint16_t color) {
  for (int j = 0; j < rowCount; j++) {
    const char* row = rows[j];
    int first = -1, last = -1;
    for (int i = 0; row[i]; i++) {
      if (row[i] == '#') { if (first < 0) first = i; last = i; }
    }
    for (int i = 0; row[i]; i++) {
      bool lit = filled ? (first >= 0 && i >= first && i <= last) : (row[i] == '#');
      if (lit) display.fillRect(x + i * scale, y + j * scale, scale, scale, color);
    }
  }
}

// ---------------- Filled ellipse, one horizontal span per row (the display library has none) ----------------
void fillEllipseSpans(int cx, int cy, int rx, int ry, uint16_t color) {
  for (int y = -ry; y <= ry; y++) {
    float t = 1.0f - (float)(y * y) / (ry * ry + 0.5f);
    int w = (int)lroundf(rx * sqrtf(t > 0 ? t : 0));
    display.drawFastHLine(cx - w, cy + y, 2 * w + 1, color);
  }
}

// ---------------- Animated per-game splashes: 12 frames of ~83 ms (1 second), the scene redrawn each
// frame above the game's name. Each scene draws one frame given its index 0-11. ----------------
const int GAME_SPLASH_FRAMES = 12;
const int GAME_SPLASH_FRAME_MS = 83;

// Reflex: a big arcade button - a tall round dome on a short collar, sitting in its bezel - presses
// down and springs back, with click lines at the bottom of the press.
void drawReflexSplashFrame(int f) {
  static const uint8_t PRESS[GAME_SPLASH_FRAMES] = {0, 0, 1, 2, 3, 3, 2, 1, 0, 0, 0, 0};
  int press = PRESS[f];
  fillEllipseSpans(64, 36, 30, 6, SH110X_WHITE); // bezel ring
  fillEllipseSpans(64, 35, 26, 4, SH110X_BLACK);
  const int domeBase = 27 + press;                                 // the cap sinks as it's pressed
  display.fillRect(42, domeBase, 45, 32 - domeBase, SH110X_WHITE); // short collar under the cap
  fillEllipseSpans(64, 31, 22, 4, SH110X_WHITE);                   // rounded bottom
  for (int dy = -14; dy <= 0; dy++) {                              // tall round dome: upper half-ellipse 45x15 (apex row skipped: it would be a 1px nub)
    float t = 1.0f - (float)(dy * dy) / (15 * 15);
    int w = (int)lroundf(22 * sqrtf(t));
    display.drawFastHLine(64 - w, domeBase + dy, 2 * w + 1, SH110X_WHITE);
  }
  for (int a = 200; a <= 245; a += 3) {                            // curved shine on the upper left
    float r = a * PI / 180;
    display.drawPixel((int)lroundf(64 + cosf(r) * 16), (int)lroundf(domeBase + sinf(r) * 10), SH110X_BLACK);
  }
  display.drawPixel(52, domeBase - 10, SH110X_BLACK);
  if (press >= 3) {
    display.drawLine(30, 8, 36, 14, SH110X_WHITE);
    display.drawLine(98, 8, 92, 14, SH110X_WHITE);
    display.drawLine(64, 0, 64, 8, SH110X_WHITE);
    display.drawLine(44, 2, 48, 10, SH110X_WHITE);
    display.drawLine(84, 2, 80, 10, SH110X_WHITE);
  }
}

void drawSplashSparkle(int x, int y, int r) {
  display.drawLine(x - r, y, x + r, y, SH110X_WHITE);
  display.drawLine(x, y - r, x, y + r, SH110X_WHITE);
  if (r > 2) {
    display.drawPixel(x - 1, y - 1, SH110X_WHITE); display.drawPixel(x + 1, y - 1, SH110X_WHITE);
    display.drawPixel(x - 1, y + 1, SH110X_WHITE); display.drawPixel(x + 1, y + 1, SH110X_WHITE);
  }
}

// Pass the Bomb: a big round bomb with a shine; its wavy fuse burns shorter every frame, the spark
// at its tip flickering and throwing off stray sparks.
void drawHotPotatoSplashFrame(int f) {
  display.fillCircle(56, 28, 14, SH110X_WHITE);
  display.fillRect(51, 11, 10, 4, SH110X_WHITE);  // cap
  display.fillCircle(49, 22, 3, SH110X_BLACK);    // shine ring
  display.fillCircle(48, 21, 2, SH110X_WHITE);
  display.drawPixel(48, 21, SH110X_BLACK);
  int len = 12 - f; // fuse segments left
  int px = 60, py = 12;
  for (int i = 1; i <= len; i++) {
    int x = 60 + i * 2;
    int y = 12 - (int)lroundf(sinf(i * 0.6f) * 3) - i;
    display.drawLine(px, py, x, y, SH110X_WHITE);
    px = x; py = y;
  }
  drawSplashSparkle(px, py, (f % 2) ? 3 : 2);
  if (f % 3 == 0) { display.drawPixel(px + 5, py - 3, SH110X_WHITE); display.drawPixel(px - 4, py - 5, SH110X_WHITE); }
  if (f % 3 == 1) { display.drawPixel(px + 4, py + 4, SH110X_WHITE); display.drawPixel(px + 6, py - 1, SH110X_WHITE); }
}

// Chess Clock: a white king (outline) and a black king (solid) face each other across a small
// chess clock whose buttons take turns going down while both hands tick.
const char* const CHESS_SPLASH_KING[] = {
  "....#....",
  "...###...",
  "....#....",
  "..#####..",
  ".#.....#.",
  "#.......#",
  "#.......#",
  ".#.....#.",
  "..#...#..",
  "..#...#..",
  "..#...#..",
  ".#.....#.",
  "#.......#",
  "#########",
};
void drawSplashClockFace(int cx, int cy, int r, float angle) {
  display.drawCircle(cx, cy, r, SH110X_WHITE);
  display.drawLine(cx, cy, cx + (int)lroundf(cosf(angle) * (r - 2)), cy + (int)lroundf(sinf(angle) * (r - 2)), SH110X_WHITE);
  display.drawPixel(cx, cy - r + 1, SH110X_WHITE); // 12 o'clock mark
}
void drawChessSplashFrame(int f) {
  const int kingRows = sizeof(CHESS_SPLASH_KING) / sizeof(CHESS_SPLASH_KING[0]);
  drawPixelArt(CHESS_SPLASH_KING, kingRows, 6, 2, 2, false, SH110X_WHITE);
  drawPixelArt(CHESS_SPLASH_KING, kingRows, 98, 2, 2, true, SH110X_WHITE);
  bool leftDown = (f % 6) < 3;
  display.drawRect(44, 18, 40, 20, SH110X_WHITE);
  drawSplashClockFace(54, 28, 6, -PI / 2 + f * 0.5f);
  drawSplashClockFace(74, 28, 6, -PI / 2 + f * 0.5f + 1);
  display.fillRect(50, leftDown ? 13 : 15, 8, leftDown ? 5 : 3, SH110X_WHITE);
  display.fillRect(70, leftDown ? 15 : 13, 8, leftDown ? 3 : 5, SH110X_WHITE);
}

// Stopwatch: a big stopwatch with a thick case and 12 tick marks; the crown clicks down on the
// first frame and the hand sweeps a full turn over the second.
void drawStopwatchSplashFrame(int f) {
  display.fillCircle(64, 24, 18, SH110X_WHITE);
  display.fillCircle(64, 24, 15, SH110X_BLACK);
  for (int i = 0; i < 12; i++) {
    float a = i * PI / 6;
    int len = (i % 3 == 0) ? 3 : 1;
    display.drawLine(64 + (int)lroundf(cosf(a) * 14), 24 + (int)lroundf(sinf(a) * 14),
                     64 + (int)lroundf(cosf(a) * (14 - len)), 24 + (int)lroundf(sinf(a) * (14 - len)), SH110X_WHITE);
  }
  float hand = -PI / 2 + f * PI / 6;
  display.drawLine(64, 24, 64 + (int)lroundf(cosf(hand) * 12), 24 + (int)lroundf(sinf(hand) * 12), SH110X_WHITE);
  display.fillCircle(64, 24, 1, SH110X_WHITE);
  int pr = (f == 0) ? 2 : 0; // crown and side button pushed down on the first frame
  display.fillRect(61, 2 + pr, 7, 3, SH110X_WHITE);
  display.fillRect(63, 4, 3, 2, SH110X_WHITE);
  display.fillTriangle(76, 7 + pr, 80, 3 + pr, 83, 6 + pr, SH110X_WHITE);
  display.fillTriangle(76, 7 + pr, 83, 6 + pr, 79, 10 + pr, SH110X_WHITE);
}

// Timer: a big hourglass in the icon's style; the sand drains from the top bulb into a growing
// pile in the bottom one, a dotted stream falling between them.
int hourglassHalfWidth(int y) { // inner wall position for row y (narrowest at the neck, y=21.5)
  return (int)lroundf(2 + fabsf(y - 21.5f) / 18.0f * 12);
}
void drawTimerSplashFrame(int f) {
  const int cx = 64;
  display.fillRect(cx - 16, 1, 33, 3, SH110X_WHITE);  // top cap
  display.fillRect(cx - 16, 40, 33, 3, SH110X_WHITE); // bottom cap
  for (int y = 4; y <= 39; y++) {                     // glass walls
    int w = hourglassHalfWidth(y);
    display.drawPixel(cx - w, y, SH110X_WHITE);
    display.drawPixel(cx + w, y, SH110X_WHITE);
  }
  int top = (int)lroundf(14 - f * 1.1f);  // rows of sand left above the neck
  int bottom = (int)lroundf(f * 1.1f);    // rows of the pile below
  for (int y = 21 - top; y <= 20; y++) {
    if (y < 6) continue;
    int w = hourglassHalfWidth(y) - 1;
    display.drawFastHLine(cx - w, y, 2 * w + 1, SH110X_WHITE);
  }
  for (int y = 39 - bottom; y <= 38; y++) {
    int w = hourglassHalfWidth(y) - 1;
    int pile = min(w, (int)lroundf((y - (39 - bottom)) * 1.6f) + 1); // cone-shaped pile
    display.drawFastHLine(cx - pile, y, 2 * pile + 1, SH110X_WHITE);
  }
  if (f < 11) {
    for (int y = 22; y < 39 - bottom; y += 2) display.drawPixel(cx, y + (f % 2), SH110X_WHITE); // falling stream
  }
}

// Dice: one outlined and one solid die tumble in from both sides, bouncing, their faces changing,
// and land on 6 and 5; sparkles once they settle.
void drawSplashDie(int x, int y, int s, int value, bool filled) {
  uint16_t pip = filled ? SH110X_BLACK : SH110X_WHITE;
  if (filled) display.fillRoundRect(x, y, s, s, 3, SH110X_WHITE);
  else display.drawRoundRect(x, y, s, s, 3, SH110X_WHITE);
  int lo = s / 4, mid = s / 2, hi = s - 1 - s / 4, pr = max(1, s / 10);
  // pip positions as (column, row) indices into {lo, mid, hi}, per face value
  static const char* const FACES[7] = {"", "11", "0022", "001122", "00200222", "0020110222", "002001210222"};
  const char* face = FACES[value];
  int pos[3] = {lo, mid, hi};
  for (int i = 0; face[i] && face[i + 1]; i += 2) {
    display.fillCircle(x + pos[face[i] - '0'], y + pos[face[i + 1] - '0'], pr, pip);
  }
}
void drawDiceSplashFrame(int f) {
  const int land = 7;
  float t = min(f, land) / (float)land;
  int bounce1 = (f < land) ? (int)lroundf(fabsf(sinf(t * 2 * PI)) * -8) : 0;
  int bounce2 = (f < land) ? (int)lroundf(fabsf(cosf(t * 2 * PI)) * -6) : 0;
  int x1 = (int)lroundf(-24 + t * 58), x2 = (int)lroundf(128 - t * 58);
  int v1 = (f < land) ? 1 + (f * 5) % 6 : 6;
  int v2 = (f < land) ? 1 + (f * 3 + 2) % 6 : 5;
  drawSplashDie(x1, 14 + bounce1, 24, v1, false);
  drawSplashDie(x2, 16 + bounce2, 24, v2, true);
  if (f >= land + 1) { drawSplashSparkle(30, 6, 2); drawSplashSparkle(100, 8, 3); }
}

// Quiz: a speech bubble whose question mark pops up (growing 1x -> 3x, then a small bounce);
// sparkles around it at the end.
void drawTriviaSplashFrame(int f) {
  display.drawRoundRect(34, 2, 60, 34, 8, SH110X_WHITE);
  display.drawRoundRect(35, 3, 58, 32, 7, SH110X_WHITE);
  display.fillTriangle(44, 34, 52, 34, 40, 43, SH110X_WHITE); // tail
  display.fillTriangle(46, 33, 50, 33, 43, 39, SH110X_BLACK);
  int sc = (f == 0) ? 1 : (f == 1) ? 2 : 3;
  int dy = (f >= 3 && f < 6) ? (f == 3 ? -2 : f == 4 ? 0 : -1) : 0;
  display.setTextSize(sc);
  display.setTextColor(SH110X_WHITE);
  display.setCursor(64 - (5 * sc) / 2, 19 - (8 * sc) / 2 + dy);
  display.print('?');
  display.setTextSize(1);
  if (f >= 8) {
    drawSplashSparkle(104, 8, 2);
    drawSplashSparkle(24, 14, (f % 2) ? 3 : 2);
    drawSplashSparkle(108, 30, (f % 2) ? 2 : 3);
  }
}

// Tetris: a big T piece of bevelled blocks falls toward a floor line, turning a quarter every
// 3 frames.
void drawTetrisSplashFrame(int f) {
  const int S = 10, cx = 64;
  int rot = (f / 3) % 4;
  int cy = (int)lroundf(-10 + f * 1.9f);
  static const int8_t BASE[4][2] = {{-1, 0}, {0, 0}, {1, 0}, {0, -1}};
  for (int i = 0; i < 4; i++) {
    int a = BASE[i][0], b = BASE[i][1];
    for (int k = 0; k < rot; k++) { int t = a; a = -b; b = t; }
    int x = cx - 5 + a * S, y = cy + 12 + b * S;
    display.fillRect(x, y, S - 1, S - 1, SH110X_WHITE);
    display.drawRect(x + 2, y + 2, S - 5, S - 5, SH110X_BLACK);
  }
  display.drawFastHLine(20, 43, 88, SH110X_WHITE);
}

// Snake: a walled arena; a 7-segment snake runs laps along a rectangular track inside it, chasing
// a food dot that stays 9 steps ahead.
void snakeArenaTrackPoint(int i, int &x, int &y) { // 44 points: top, right, bottom, left
  if (i < 17) { x = 30 + i * 4; y = 8; return; }
  i -= 17;
  if (i < 6) { x = 96; y = 12 + i * 4; return; }
  i -= 6;
  if (i < 16) { x = 92 - i * 4; y = 34; return; }
  i -= 16;
  x = 30; y = 30 - i * 4;
}
void drawSnakeSplashFrame(int f) {
  const int n = 44;
  display.drawRect(24, 2, 80, 40, SH110X_WHITE);
  int head = (f * 3) % n, x, y;
  for (int k = 0; k < 7; k++) {
    snakeArenaTrackPoint((head - k + n) % n, x, y);
    display.fillRect(x, y, 3, 3, SH110X_WHITE);
  }
  snakeArenaTrackPoint((head + 9) % n, x, y);
  display.fillRect(x, y, 3, 3, SH110X_WHITE);
  display.drawPixel(x + 1, y + 1, SH110X_BLACK);
}

// Pong: a rally - the ball crosses to the right and back over the dashed centre line, bouncing
// between top and bottom, both paddles following it.
void drawPongSplashFrame(int f) {
  for (int y = 0; y < 44; y += 4) display.drawFastVLine(64, y, 2, SH110X_WHITE);
  int bx = 10 + ((f < 6) ? f * 18 : (12 - f) * 18);
  int by = (int)lroundf(8 + abs(((f * 7) % 24) - 12) * 2.3f);
  display.fillRect(bx, by, 3, 3, SH110X_WHITE);
  display.fillRect(4, constrain(by - 6, 2, 30), 3, 12, SH110X_WHITE);
  display.fillRect(121, constrain(by - 4 + (f % 3), 2, 30), 3, 12, SH110X_WHITE);
}

// SimpleMorse: a big telegraph key taps out a pattern (lever and knob dip on key-down frames) while
// the dots and dashes it has sent so far grow to its right.
void drawSimpleMorseSplashFrame(int f) {
  static const uint8_t PATTERN[GAME_SPLASH_FRAMES] = {1, 1, 0, 1, 1, 1, 0, 1, 0, 0, 1, 1};
  int ly = PATTERN[f] ? 3 : 0;
  display.fillRect(6, 36, 56, 6, SH110X_WHITE);  // base
  display.fillRect(40, 26, 6, 10, SH110X_WHITE); // pivot post
  display.drawLine(10, 22 + ly, 54, 28, SH110X_WHITE); // lever
  display.drawLine(10, 23 + ly, 54, 29, SH110X_WHITE);
  display.drawLine(10, 24 + ly, 54, 30, SH110X_WHITE);
  display.fillCircle(12, 20 + ly, 5, SH110X_WHITE); // knob
  display.fillRect(46, 33, 8, 3, SH110X_WHITE);     // contact
  int x = 70;
  for (int i = 0; i <= f; i++) {
    if (PATTERN[i] && (i == 0 || !PATTERN[i - 1])) { // start of a key-down run
      int n = 0;
      while (i + n <= f && i + n < GAME_SPLASH_FRAMES && PATTERN[i + n]) n++;
      int w = (n >= 3) ? 10 : 3; // a dash once the key has been held 3 frames
      display.fillRect(x, 22, w, 3, SH110X_WHITE);
      x += w + 4;
    }
  }
}

// true if the game has an animated splash above (drawn by playAnimatedGameSplash)
bool hasAnimatedGameSplash(int game) {
  return game == GAME_REFLEX || game == GAME_HOTPOTATO || game == GAME_CHESS || game == GAME_STOPWATCH ||
         game == GAME_TIMER || game == GAME_DICE || game == GAME_TRIVIA || game == GAME_TETRIS ||
         game == GAME_SNAKE || game == GAME_PONG || game == GAME_SIMPLEMORSE;
}

void playAnimatedGameSplash(int game) {
  for (int f = 0; f < GAME_SPLASH_FRAMES; f++) {
    display.clearDisplay();
    if (game == GAME_REFLEX) drawReflexSplashFrame(f);
    else if (game == GAME_HOTPOTATO) drawHotPotatoSplashFrame(f);
    else if (game == GAME_CHESS) drawChessSplashFrame(f);
    else if (game == GAME_STOPWATCH) drawStopwatchSplashFrame(f);
    else if (game == GAME_TIMER) drawTimerSplashFrame(f);
    else if (game == GAME_DICE) drawDiceSplashFrame(f);
    else if (game == GAME_TRIVIA) drawTriviaSplashFrame(f);
    else if (game == GAME_TETRIS) drawTetrisSplashFrame(f);
    else if (game == GAME_SNAKE) drawSnakeSplashFrame(f);
    else if (game == GAME_PONG) drawPongSplashFrame(f);
    else if (game == GAME_SIMPLEMORSE) drawSimpleMorseSplashFrame(f);
    drawSplashGameName(menuLabelForGame(game));
    display.display();
    delay(GAME_SPLASH_FRAME_MS);
  }
}

// ---------------- Toothbrush splash: a big toothbrush lying across the screen while a tube moves
// along it squeezing a wavy ribbon of toothpaste onto the bristles, then a sparkle - 12 frames of
// ~83 ms, 1 second in total like every other game's splash. ----------------
void drawToothbrushSplashBrush(int x, int y) {
  display.fillRect(x, y + 6, 30, 4, SH110X_WHITE);                    // head
  for (int i = 1; i < 30; i += 3) display.fillRect(x + i, y, 2, 6, SH110X_WHITE); // bristle tufts
  display.fillRect(x + 30, y + 7, 6, 2, SH110X_WHITE);                // neck
  display.fillRect(x + 35, y + 6, 52, 5, SH110X_WHITE);               // handle
  display.drawFastHLine(x + 36, y + 11, 50, SH110X_WHITE);
  display.drawRect(x + 74, y + 7, 8, 2, SH110X_BLACK);                // grip slot
}

void drawToothbrushSplashTube(int x, int y) {
  display.fillRect(x, y, 4, 3, SH110X_WHITE);           // nozzle
  display.drawRect(x + 4, y - 3, 22, 9, SH110X_WHITE);  // body
  display.drawFastHLine(x + 8, y - 1, 13, SH110X_WHITE); // label stripe
  display.drawFastVLine(x + 26, y - 3, 9, SH110X_WHITE); // crimped end
  for (int k = 0; k < 4; k++) display.drawPixel(x + 26, y - 2 + k * 2, SH110X_WHITE);
}

void playToothbrushSplash() {
  const int brushX = 14, brushY = 26;
  for (int frame = 0; frame < 12; frame++) {
    display.clearDisplay();
    drawToothbrushSplashBrush(brushX, brushY);
    int n = min(4 + frame * 3, 30); // paste length so far, along the bristles
    for (int i = 0; i < n; i++) {
      int yy = 21 + (int)lroundf(sinf(i * 0.8f) * 1.2f);
      display.drawFastVLine(brushX + i, yy, 4, SH110X_WHITE);
    }
    display.fillRect(brushX + n - 1, 19, 2, 2, SH110X_WHITE); // paste still leaving the nozzle
    drawToothbrushSplashTube(brushX + n, 12);
    if (frame >= 10) { // sparkle once the paste is on
      display.drawLine(27, 8, 33, 8, SH110X_WHITE);
      display.drawLine(30, 5, 30, 11, SH110X_WHITE);
      display.drawPixel(29, 7, SH110X_WHITE); display.drawPixel(31, 7, SH110X_WHITE);
      display.drawPixel(29, 9, SH110X_WHITE); display.drawPixel(31, 9, SH110X_WHITE);
    }
    drawSplashGameName(menuLabelForGame(GAME_TOOTHBRUSH));
    display.display();
    delay(83);
  }
}

// ---------------- Star Drop splash: a ringed planet with a crescent moon in a starfield, the
// stars twinkling for the 1 s it's shown (8 frames). The ring is a tilted ellipse: its back half is
// hidden behind the planet, its front half drawn over it with a dark gap line under it. ----------------
const uint8_t STARDROP_SPLASH_STARS[][2] = {
  {6,4},{19,13},{33,3},{47,18},{58,7},{72,2},{86,15},{99,5},{113,12},{122,3},
  {10,28},{28,34},{64,30},{92,34},{118,26},{40,9},{105,22}
};
const int STARDROP_SPLASH_STAR_COUNT = sizeof(STARDROP_SPLASH_STARS) / sizeof(STARDROP_SPLASH_STARS[0]);

void drawStarDropSplashRing(int cx, int cy, bool frontHalf, bool gap) {
  for (int a = 0; a < 360; a += 2) {
    float r = a * PI / 180.0f;
    float ex = cosf(r) * 21, ey = sinf(r) * 5;
    int x = (int)(cx + ex * 0.97f - ey * 0.25f);
    int y = (int)(cy + ex * 0.25f + ey * 0.97f);
    bool front = sinf(r) >= 0;
    if (front != frontHalf) continue;
    if (!front && (x - cx) * (x - cx) + (y - cy) * (y - cy) <= 132) continue; // behind the planet
    display.drawPixel(x, y, SH110X_WHITE);
    if (gap) display.drawPixel(x, y + 1, SH110X_BLACK); // gap separating the ring from the body
  }
}

void playStarDropSplash() {
  const int planetX = 64, planetY = 21;
  for (int frame = 0; frame < 8; frame++) {
    display.clearDisplay();
    for (int i = 0; i < STARDROP_SPLASH_STAR_COUNT; i++) {
      int x = STARDROP_SPLASH_STARS[i][0], y = STARDROP_SPLASH_STARS[i][1];
      if ((i + frame) % 4 == 0) { // twinkle: a small cross instead of a dot
        display.drawFastHLine(x - 1, y, 3, SH110X_WHITE);
        display.drawFastVLine(x, y - 1, 3, SH110X_WHITE);
      } else {
        display.drawPixel(x, y, SH110X_WHITE);
      }
    }
    display.fillCircle(planetX, planetY, 12, SH110X_BLACK); // clear stars just around the planet
    drawStarDropSplashRing(planetX, planetY, false, false);
    display.fillCircle(planetX, planetY, 11, SH110X_WHITE);
    drawStarDropSplashRing(planetX, planetY, true, true);
    drawStarDropSplashRing(planetX, planetY, true, false); // restores ring pixels a neighbour's gap erased
    display.fillCircle(104, 10, 6, SH110X_WHITE);   // crescent moon
    display.fillCircle(107, 8, 6, SH110X_BLACK);
    drawSplashGameName(menuLabelForGame(GAME_STARDROP));
    display.display();
    delay(125);
  }
}

// ---------------- Instructions screen: closes back to the menu (arcade button, or encoder click
// via the generic "close menu hierarchy" handling in readEncoderButton) ----------------
void closeInstructions() {
  inInstructions = false;
  inMenu = true;
  menuSelection = menuPositionForGame(MENU_INSTRUCTIONS);
  render();
}
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
