pierre-raseev/tiger-timer/Code/tiger_timer/press_start_2p_font.h

// Press Start 2P, 8px, converted from PressStart2P-Regular.ttf for use as an
// Adafruit_GFX custom font (matches the boot splash's "TIGER"/"TIMER" wordmark style).
// Covers ASCII 32-126 plus CP437 0x82 (é) and 0x8A (è) used by the French menu labels.
#ifndef _PRESSSTART2P8PT_H_
#define _PRESSSTART2P8PT_H_

#include <Adafruit_GFX.h>

const uint8_t PressStart2P8ptBitmaps[] PROGMEM = {
  0x00, 0x00, 0x00, 0x00, 0x00, 0x00, 0x00, 0x00, 0x38, 0x38, 0x38, 0x30,
  0x30, 0x00, 0x30, 0x00, 0x6C, 0x6C, 0x6C, 0x00, 0x00, 0x00, 0x00, 0x00,
  0x6C, 0xFE, 0x6C, 0x6C, 0x6C, 0xFE, 0x6C, 0x00, 0x10, 0x7C, 0xD0, 0x7C,
  0x16, 0xFC, 0x10, 0x00, 0x62, 0xA4, 0xC8, 0x10, 0x26, 0x4A, 0x8C, 0x00,
  0x70, 0xD8, 0xD8, 0x70, 0xDA, 0xCC, 0x7E, 0x00, 0x30, 0x30, 0x30, 0x00,
  0x00, 0x00, 0x00, 0x00, 0x0C, 0x18, 0x30, 0x30, 0x30, 0x18, 0x0C, 0x00,
  0x60, 0x30, 0x18, 0x18, 0x18, 0x30, 0x60, 0x00, 0x00, 0x6C, 0x38, 0xFE,
  0x38, 0x6C, 0x00, 0x00, 0x00, 0x18, 0x18, 0x7E, 0x18, 0x18, 0x00, 0x00,
  0x00, 0x00, 0x00, 0x00, 0x00, 0x30, 0x30, 0x60, 0x00, 0x00, 0x00, 0x7E,
  0x00, 0x00, 0x00, 0x00, 0x00, 0x00, 0x00, 0x00, 0x00, 0x30, 0x30, 0x00,
  0x02, 0x04, 0x08, 0x10, 0x20, 0x40, 0x80, 0x00, 0x38, 0x4C, 0xC6, 0xC6,
  0xC6, 0x64, 0x38, 0x00, 0x18, 0x38, 0x18, 0x18, 0x18, 0x18, 0x7E, 0x00,
  0x7C, 0xC6, 0x0E, 0x3C, 0x78, 0xE0, 0xFE, 0x00, 0x7E, 0x0C, 0x18, 0x3C,
  0x06, 0xC6, 0x7C, 0x00, 0x1C, 0x3C, 0x6C, 0xCC, 0xFE, 0x0C, 0x0C, 0x00,
  0xFC, 0xC0, 0xFC, 0x06, 0x06, 0xC6, 0x7C, 0x00, 0x3C, 0x60, 0xC0, 0xFC,
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
  { 280, 8, 8, 8, 0, -8 },
  { 288, 8, 8, 8, 0, -8 },
  { 296, 8, 8, 8, 0, -8 },
  { 304, 8, 8, 8, 0, -8 },
  { 312, 8, 8, 8, 0, -8 },
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
};

const GFXfont PressStart2P8pt PROGMEM = {
  (uint8_t *)PressStart2P8ptBitmaps,
  (GFXglyph *)PressStart2P8ptGlyphs,
  32, 138, 10
};

#endif
