pierre-raseev/tiger-timer/(commit log)

2026-11-05 Initial import of Tiger Timer firmware and FSD bundle
    Firmware sketch (tiger_timer/) and FSD/DevPlan docs (20260824, 20260829) as built in Claude chat.
    [animals_curious.csv, animals_junior.csv, animals_master.csv, art_curious.csv, art_junior.csv, art_master.csv, general_curious.csv, general_junior.csv]
2026-11-05 Fix web editor corrupting accented trivia text
    The device stores trivia CSVs in CP437 (the OLED font's charset) but the
    web page speaks UTF-8. Raw CP437 bytes were sent as JSON, the browser
    turned every accent into U+FFFD, and Save wrote that back permanently.
    - Add cp437_utf8.h: CP437<->UTF-8 conversion with readable ASCII
    fallbacks (smart quotes, dashes, oe, accented capitals)
    - Convert on GET/POST /api/trivia, CSV download (UTF-8 + BOM) and the
    Pass the Bomb names in /api/config
    - config.html decodes uploaded CSVs as UTF-8, CP437 or Windows-1252
    - FSD 5.8/7.2/7.3 updated
    [cp437_utf8.h, tiger_timer.ino, web_config.ino]
2026-11-05 Fix Reflex: holding the button through the light scored negative times
    A false start was only judged on button release, so pressing during WAIT
    and releasing after the light came on scored a negative reaction time
    that became the session best. Now the false start fires on the press
    itself and that press is consumed; a hit whose press predates the light
    is also treated as a false start. FSD 5.2 updated.
    [tiger_timer.ino]
2026-11-05 Make the input that wakes a sleeping screen only wake it
    A press or turn on a dark OLED used to both wake it and perform an
    action the user couldn't see (restart a timer, arm a round, open a menu
    entry). registerActivity() now reports whether it woke the screen, and
    the arcade button, encoder turn and encoder hold swallow that gesture.
    FSD 3.3 updated.
2026-11-05 Remote Config: auto-exit when abandoned, clean exit, register routes once
    - Exit automatically after 5 min with no client connected or 30 min with
    no web request, since Config Mode blocks screen/deep sleep and a
    forgotten session drained the battery
    - Wait for the exit button to be released before returning, so a long
    exit press no longer reopens Settings
    - Register web routes only once per boot instead of appending duplicate
    handlers on every visit
    - FSD 7.1 updated
    [web_config.ino]
2026-11-05 Fix Snake tail collision, drop blank trivia rows, clamp high scores
    - Snake: moving into the cell the tail is leaving no longer ends the game
    - Web editor: rows with no question text are dropped on save instead of
    playing as blank questions
    - High scores are clamped to 65535 when saved instead of wrapping
    - Fix stale comments (Turn Order range, Snake grid size)
    - FSD 3.5, 5.12, 7.2 updated
    [tiger_timer.ino, web_config.ino]
2026-11-05 Print a one-line boot summary on USB serial
    Reports OLED and LittleFS status, filesystem usage, whether config.html
    and the trivia data are present, and the active language, so a connected
    computer can confirm a healthy boot without looking at the screen.
    FSD 3.1 updated. Ignore local device filesystem backups.
2026-11-05 FSD: match code for stopwatch, game re-entry, Remote Config exit
    - Stopwatch is Ready -> Running -> Stopped -> Ready, no pause/resume.
    - Leaving a game is not a suspend: re-entry runs initGameState(), so
    Chess Clock and Stopwatch start fresh (Timer keeps its remaining time).
    - Remote Config exits to the main menu with Settings highlighted.
2026-11-05 Fix deep sleep waking instantly (reboot + chime at 30 min idle)
    ext1 hands the wake pin to the LP-IO block, whose pull-up is separate
    from the digital INPUT_PULLUP set in setup(). With it off the pin
    floated low and the chip woke the instant it slept. Enable the LP
    pull-up before sleeping, release the pin back to GPIO on boot.
    Also: boot banner prints reset reason + wake cause; build-time flags
    TT_DEEP_SLEEP_TIMEOUT_MS / TT_SLEEP_TEST_TIMER_WAKE_S for bench tests.
    Verified on device: 20s test timeout now stays asleep until the 40s
    test timer (previously woke in ~1s). FSD 2.x / 3.1 updated.
    [tiger_timer.ino]
2026-11-05 Toothbrush: 6 zones and a realistic teeth screen
    - 6 equal zones: upper left/front/right, then lower left/front/right.
    Sounds unchanged; the zone-change beep now plays at each of the 6.
    - Running screen: front view of upper and lower teeth arches (24 teeth),
    outlined until brushed, solid once done, active zone blinking with the
    scrub clicks. A brush sprite scrubs the active zone with foam bubbles.
    Right panel: Brush!/Paused, time, two-line zone name, zone progress bar.
    - Zone labels in EN/FR/ES (reuses the 4 old quadrant string slots + 1).
    - TT_SCREEN_DUMP test-only build flag: drive the toothbrush over serial
    and dump the OLED buffer as text. Used to verify every zone on device.
    -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
2026-11-05 Remove the Turn Order game completely
    - Game code, screen, icon, encoder/press handling, 3 strings and its
    web-config entry are gone. Game ids after it shift down by one
    (12 games, 14 menu entries); string ids renumbered to stay contiguous.
    - migrateSavedGameIds(): one-time conversion of settings saved by older
    firmware (menu order, enabled games, start-up game), marked idVer=2.
    Verified on device: the saved menu converts correctly, nothing lost.
    - TT_SCREEN_DUMP builds get an 'm' command listing the visible menu.
    - FSD: section 5.6 removed, game sections and refs renumbered, saved
    id numbering + migration documented.
    [tiger_timer.ino, web_config.ino]
2026-11-05 SimpleMorse: 136-word pool, truly random picks
    - Word pool grows from 17 to 136 short everyday English words, all
    verified for 10-15 Morse symbols and for fitting the Ready screen
    columns (TRIVIA dropped: its V is too wide for a 6-letter column).
    - Never the same word twice in a row.
    - randomSeed now uses the hardware RNG: micros() at boot is nearly the
    same every power-up, so the same 'random' words came back each time.
    Verified on device: two boots give different word sequences.
    - TT_SCREEN_DUMP builds get a 'w' command printing 10 word picks.
    [tiger_timer.ino]
2026-11-05 SimpleMorse: word pool follows the selected language
    - French (110 words) and Spanish (96 words) pools alongside English
    (136), chosen by currentLanguage when a word is picked.
    - Same rules as English (10-15 Morse symbols, fits the Ready screen),
    plus accent-free spelling only, since Morse here is plain A-Z.
    - TT_SCREEN_DUMP builds get 'L' (cycle language in RAM only).
    Verified on device: picks come from the right pool in all 3 languages.
2026-11-06 Add Pong: 1 player vs computer, encoder-controlled paddle
    - New game (id 12, menu between Snake and SimpleMorse): encoder moves the
    paddle 4 px/detent, arcade/encoder click start + pause. 3 lives, +1 per
    return, +5 past the computer; ball speeds up per return, computer gets
    faster and aims better as rallies go on. Fixed 10 ms physics, ~30 fps
    redraw cap so the encoder isn't starved by I2C transfers.
    - High score persisted (pgHigh), shown on Ready/Game Over, resettable in
    Remote Config's High scores list like Tetris (API + config.html).
    - Saved settings migration v2 -> v3 inserts Pong after Snake in a saved
    menu order and enables it (verified on device: menu kept, idVer=3).
    - TT_S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
    [tiger_timer.ino, web_config.ino]
2026-11-06 Read the encoder in an interrupt with a quadrature decoder
    Fast spins no longer drop detents during screen transfers, and contact
    bounce no longer reads as a backwards step (Pong paddle jitter). Detents
    are batched per loop pass with one redraw; Pong applies a batch at once.
    [tiger_timer.ino]
2026-11-06 New icons and animated splashes for Timer, Dice, Quiz, Tetris, Snake, Pong, SimpleMorse
2026-11-06 Hourglass Timer icon and splash; new Instructions, Settings and Language icons
2026-11-06 Dice icon: single five-pip die
2026-11-06 Nudge Timer and Quiz menu icons down 1 px
2026-11-06 Confetti animation when the Timer reaches zero
2026-11-06 Totoro-style shiny grin when the Toothbrush timer finishes
    SimpleMorse keeps the firework celebration it used to share.
2026-11-06 Timer end: hourglass flip instead of confetti
    [tiger_timer.ino]
2026-11-06 Timer end: keep only the original rising jingle
2026-11-06 Reflex splash: round dome arcade button
2026-11-09 FSD: add wiring diagram (§2.7) and schematic SVG
2026-11-09 Power: battery on XIAO BAT pads, no TP4056
    The box has no separate charger: the LiPo is soldered to the XIAO's BAT
    pads through the power switch and charges via the XIAO's own USB-C, only
    while switched on. Updates FSD §2.6/§2.7, the wiring diagram and the
    sketch header comment.
2026-11-09 FSD wiring: recommended cable colours
    Diagram wires are drawn in the actual cable colour, and the §2.7 pin
    table gains a Wire column: red = battery + / 3V3, black = GND, one
    colour per signal (SDA blue, SCL yellow).
2026-11-09 Wiring: OLED and encoder are one combined module
    The display and EC11 encoder share a single 1.3" OLED + encoder board
    (header CON SDA SCL PSH TRA TRB BAK GND VCC). Redraws the schematic
    with one module box and its header in printed order, and updates FSD
    §2.2, §2.4, §2.7 and the sketch header. Pin assignments unchanged;
    BAK/CON buttons not connected.
2026-11-09 Wiring diagram: label each wire with its colour name
2026-11-09 Wiring: JST XH connectors J1–J6
    Diagram and FSD §2.6/§2.7 now show the JST XH plugs: J1 at the LiPo,
    J2 between the power switch and the XIAO, J3 3-pin arcade button
    (switch, shared GND, LED), J4 buzzer, J5 module power and J6 module
    signals. I2C is rerouted round the module so J6's five pins sit together.
2026-11-09 Pins: arcade LED to D2, buzzer to D3
    Swaps the two so the arcade button's switch (D1) and LED (D2) sit on
    adjacent pins. J3 is now 1 switch, 2 LED, 3 GND. Diagram and FSD
    updated to match; the switch stays on D1, so deep-sleep wake is unchanged.
    [tiger_timer.ino]
2026-11-10 Wiring: module pins in the real header order
    The OLED + encoder module is now drawn with its pins in the order printed
    on the board (back view, left to right: 3V3-5V GND BAK TRB TRA PUSH SCL
    SDA CONFIRM). J5 is now VCC, GND and J6 is TRB, TRA, PUSH, SCL, SDA so the
    module-side leads run straight off the header; the wires cross over on the
    XIAO side. PSH renamed PUSH to match the silkscreen. No pin assignment or
    firmware behaviour changes.
2026-11-10 Wiring: arcade button switch and LED have separate ground leads
    Both leads go into J3 pin 3; J3 stays 3P.
2026-11-10 Wiring: J3 becomes XH 4P, one pin per arcade button ground
    Pins: 1 switch D1, 2 LED D2, 3 LED − GND, 4 switch GND.
2026-11-11 Wiring: mark the buzzer's + lead
2026-11-11 Remote Config QR: camera-friendly OLED refresh and whole-pixel modules
    Phone cameras caught only part of the SH1106 row scan, leaving a dark band
    across the QR. While Remote Config is shown, raise the display oscillator to
    max and shorten pre-charge (~2x frame rate), restored on exit. Draw the QR at
    exactly 2px per module (58px) instead of a fractional 48px; French connect
    text re-split to fit the narrower column.
    [tiger_timer.ino, web_config.ino]
2026-11-11 Boot: blank the OLED RAM before init, no random-pixel flash on power-up
2026-11-11 Firmware update from Remote Config, page embedded in firmware, v1.0.0
    - Remote Config page moves to web/config.html and is gzipped into the firmware
    (tools/embed_config_html.py -> config_html.h), so a firmware update also
    updates the page and never touches the trivia files on LittleFS.
    - New Firmware update section: shows the version, uploads a .bin into the
    spare OTA slot after an arcade-button confirmation on the box; installs only
    if the file carries the Tiger Timer marker and passes the ESP32 image check.
    - Hint to open http://192.168.4.1 in a real browser if the captive pop-up
    can't upload.
    - FW_VERSION 1.0.0; tools/release.sh builds and publishes a GitHub release.
    Co-Authore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
2026-11-11 v1.0.2: usage instructions on the Remote Config page, GitHub link
    - New 'How to use Tiger Timer' section at the top of the page: power and
    charging, controls, sleep, on-box settings.
    - Firmware update section links to the public GitHub releases page.
    - Box Instructions screen: 'More: Go to Settings > Remote Config' on two lines.
2026-11-11 Move repo root up to Tiger Timer/: firmware under Code/, add 3D enclosure
    - Everything that was at the root is now under Code/ (pure renames).
    - 3D/: FreeCAD source, STEP export and print-ready 3MF of the case.
    - README moves to the root with updated paths and an Enclosure section.
    - Ignore FreeCAD backup files.
    [Game Timer v1.9.1-double.3mf, Game Timer v1.9.1.FCStd, Game Timer v1.9.1.step, animals_curious.csv, animals_junior.csv, animals_master.csv, art_curious.csv, art_junior.csv]
2026-11-11 v1.0.4: Remote Config instructions note the light blinks red while charging
2026-11-11 v1.0.6: charging instructions point to the red light next to the charging port
2026-11-11 Add photos of the finished box and the enclosure render to the README
2026-11-11 README: games as a described list, Construction section with wiring diagram, drop menu render
